MyoRobotics/MyoRobotics-Documentation/source/assembly/overview-joints-ass.rst

Joints
######

.. toctree::
   :maxdepth: 1
   :glob:

   joint-ass-j22.rst
