MyoRobotics/MyoRobotics-Documentation/source/designPrimitives/designPrimitivesLibrary.rst

Content of the design primitive library
=======================================

Organization and description of the library elements
----------------------------------------------------

To simplify the presentation of the library elements and provide a
framework for future extensions, the developed hardware elements are
organized, for each DP functional category, using the following
hierarchical classification:

Types        (T)    are used to distinguish the hardware elements on the basis of their design principle.

Varieties    (V)    are used, if needed, to distinguish the hardware elements based on the same design principles, on the basis of the technical implementation.

The description of each variety follows the following structure:

+----------------------------------+--------------------------------------------------------------------------------------------------------------------------------+
| Illustrations                    | regroup figure and graphics illustrating the library element and its main features                                             |
+==================================+================================================================================================================================+
| Dimensions                       | list the element’s most important dimensions                                                                                   |
+----------------------------------+--------------------------------------------------------------------------------------------------------------------------------+
| Features                         | provide a textual explanation of the element’s main features                                                                   |
+----------------------------------+--------------------------------------------------------------------------------------------------------------------------------+
| Material and fabrication         | detail the materials and fabrication methods foreseen for the various parts of the library element                             |
+----------------------------------+--------------------------------------------------------------------------------------------------------------------------------+
| Integration of the electronics   | if needed, provides more details about the embedded electronic component and their integration in the hardware element         |
+----------------------------------+--------------------------------------------------------------------------------------------------------------------------------+
| Accessories                      | lists the additional pieces of hardware usable with the library element, if any                                                |
+----------------------------------+--------------------------------------------------------------------------------------------------------------------------------+
| Implemented instances            | list the instances of the hardware elements that have been implemented so far, with their corresponding names and dimensions   |
+----------------------------------+--------------------------------------------------------------------------------------------------------------------------------+

Overview of the implemented library elements
--------------------------------------------

Mechanical couplings
~~~~~~~~~~~~~~~~~~~~

Structural Bond
++++++++++++++++++++++++++++++++++++++++++++++
.. _D3.4_image1:
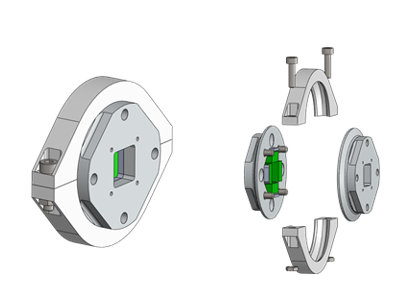
[picture p31: source/designPrimitives/images/image1.png]


   Type 1: Flange clamp with conical flange

Anchor Fastener
++++++++++++++++++++++++++++++++++++++++++++++

.. _D3.4_image3:
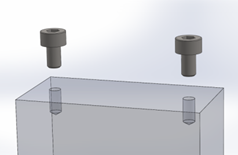
[picture p32: source/designPrimitives/images/image3.png]


    Type 1: Screw Fasteners

Cable attachment
++++++++++++++++++++++++++++++++++++++++++++++

.. _D3.4_image4:
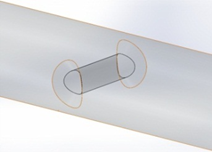
[picture p33: source/designPrimitives/images/image4.png]


    Type 1: Through hole

.. _D3.4_image5:
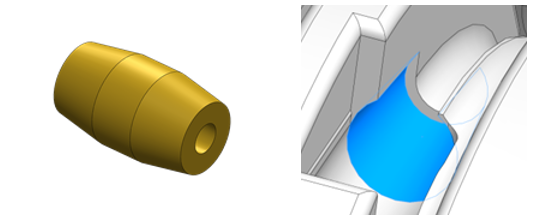
[picture p34: source/designPrimitives/images/image5.png]


    Type 2: Conical socket

Design Primitives
~~~~~~~~~~~~~~~~~

MYO-Bones
++++++++++++++++++++++++++++++++++++++++++++++

.. _D3.4_image7:
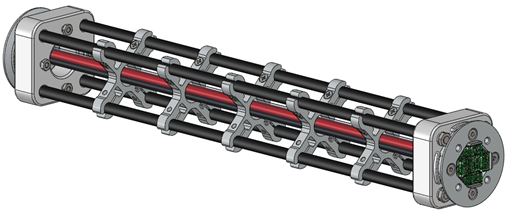
[picture p35: source/designPrimitives/images/image7.png]


    Type 1: Parallel Assemblies - Four Round Tubes Fibres

.. _D3.4_image8:
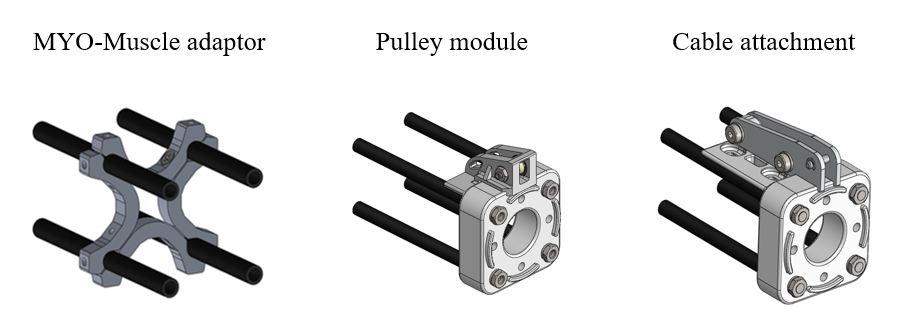
[picture p36: source/designPrimitives/images/image8.png]


    Accessories

.. _D3.4_image11:
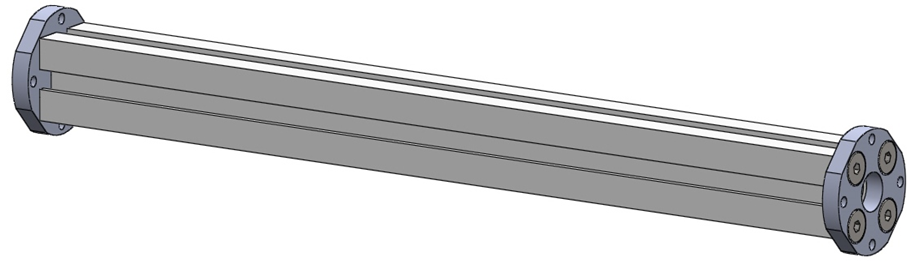
[picture p37: source/designPrimitives/images/image11.png]


    Type 2: Monolithic core - T-slot profile

.. _D3.4_image12:
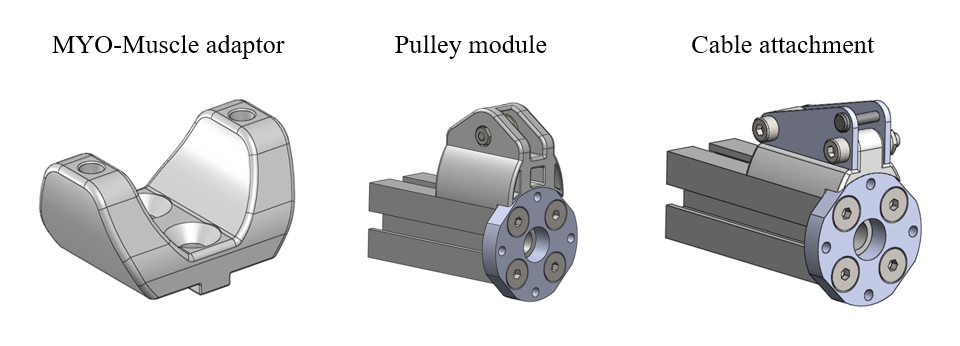
[picture p38: source/designPrimitives/images/image12.png]


    Accessories

MYO-Joints
++++++++++++++++++++++++++++++++++++++++++++++

.. _D3.4_image15:
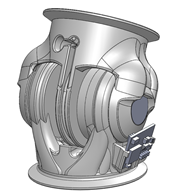
[picture p39: source/designPrimitives/images/image15.png]


    Type 1: Symmetric Hinge

.. _D3.4_image16:
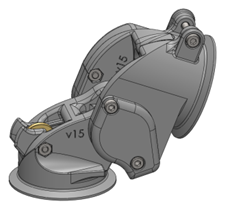
[picture p40: source/designPrimitives/images/image16.png]


    Type 2: Asymmetric Hinge

.. _D3.4_image17:
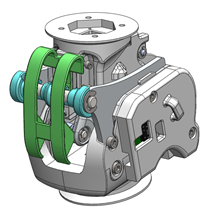
[picture p41: source/designPrimitives/images/image17.png]


    Type 2: Revised Asymmetric Hinge

.. _D3.4_image18:
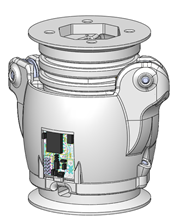
[picture p42: source/designPrimitives/images/image18.png]


    Type 3: Pivot

.. _D3.4_image19:
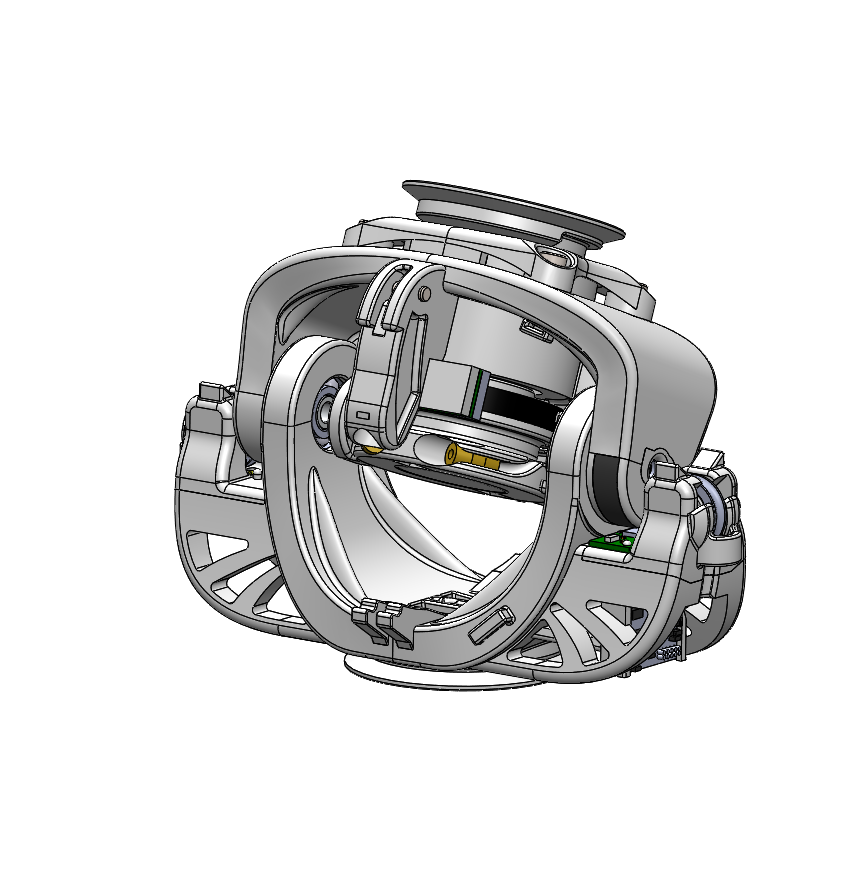
[picture p43: source/designPrimitives/images/image19.png]


    Type 4: Hinge-Pivot

.. _D3.4_image20:
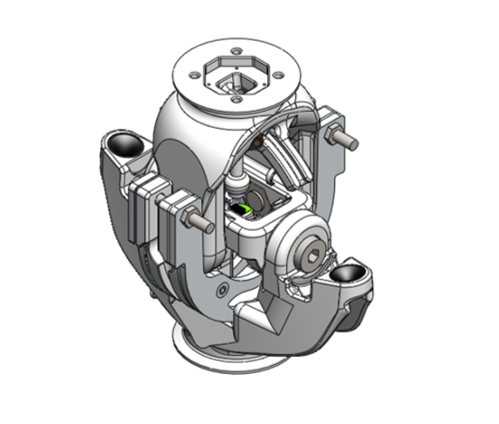
[picture p44: source/designPrimitives/images/image20.png]


    Type 5: Hinge-Hinge

MYO-Muscles
++++++++++++++++++++++++++++++++++++++++++++++

.. _D3.4_image21:
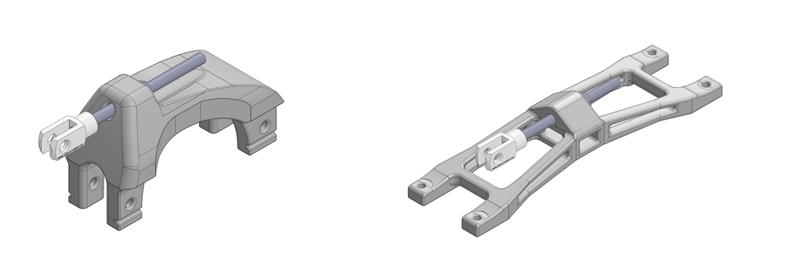
[picture p45: source/designPrimitives/images/image21.png]


    Type 0: Passive Muscle - Simple spring

.. _D3.4_image23:
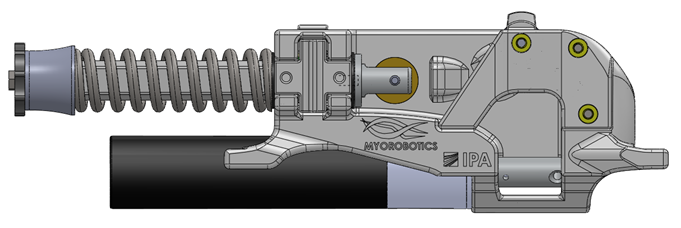
[picture p46: source/designPrimitives/images/image23.png]


    Type 1: Unilateral Series Elastic Actuator - Compression spring

MYO-Ganglion
++++++++++++++++++++++++++++++++++++++++++++++

.. _D3.4_image24:
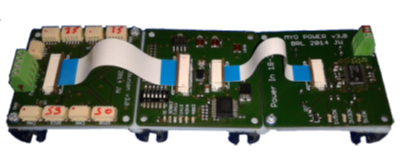
[picture p47: source/designPrimitives/images/image24.png]


    Type 1: ECU with FlexRay bus
