MyoRobotics/MyoRobotics-Documentation/source/partners/GI.rst

General Interfaces
===================
`General Interfaces
<https://www.gi.ai/#>`_ can provide fully assembled solutions based on MyoRobotics components.
