MyoRobotics/MyoRobotics-Documentation/source/controllers/images/CanConnectionMyoGanglionToDistributionBoard.pdf

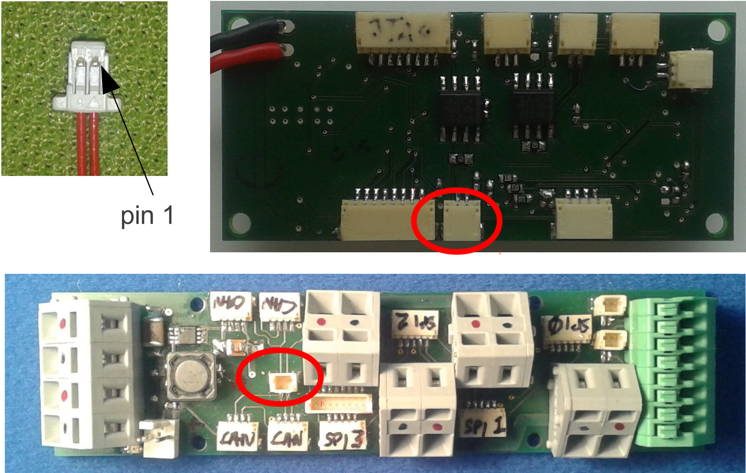
[picture p142: page 1]

pin 1
