MyoRobotics/MyoRobotics-Documentation/source/controllers/images/FlexRayConnectionMyoGanglionToDistributionBoard.pdf

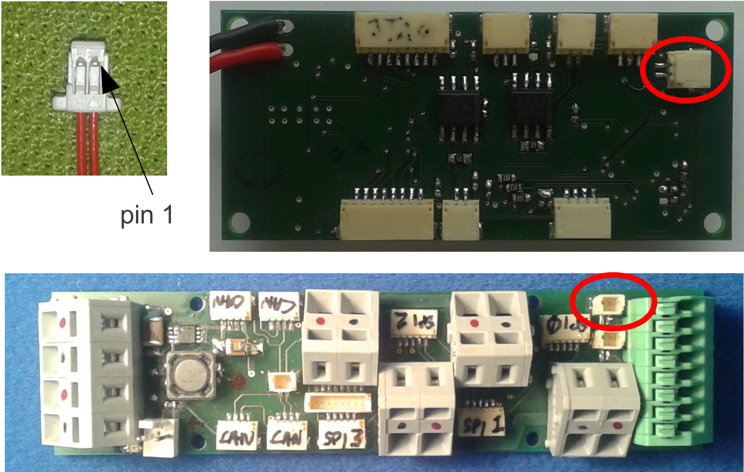
[picture p143: page 1]

pin 1
