MyoRobotics/MyoRobotics-Documentation/source/controllers/images/ganglionBoardWithLabelsHeatsink.pdf

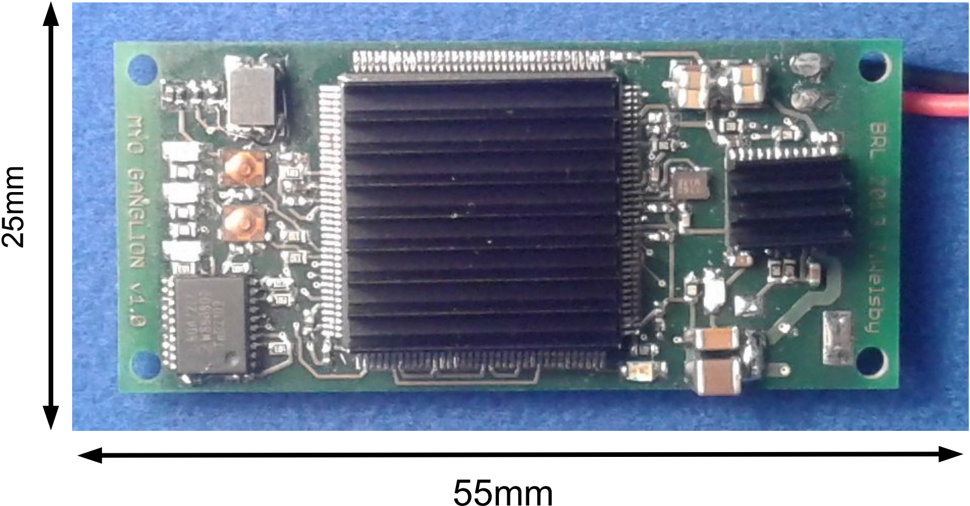
[picture p144: page 1]

55mm

2

5

m

m
