MyoRobotics/MyoRobotics-Documentation/source/controllers/images/jointAngleSensorWithConnector.pdf

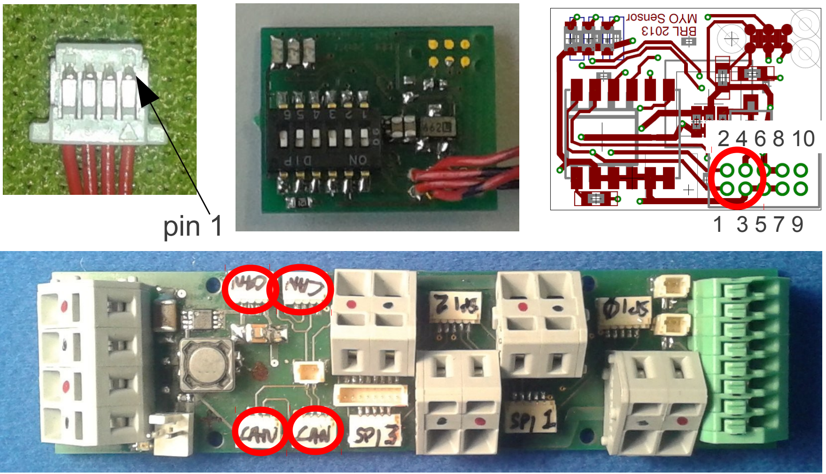
[picture p145: page 1]

pin 1 | 1 3 5 7 9 2 4 6 8 10
