MyoRobotics/MyoRobotics-Documentation/source/controllers/images/jointAngleSensorWithMagneticSensor.pdf

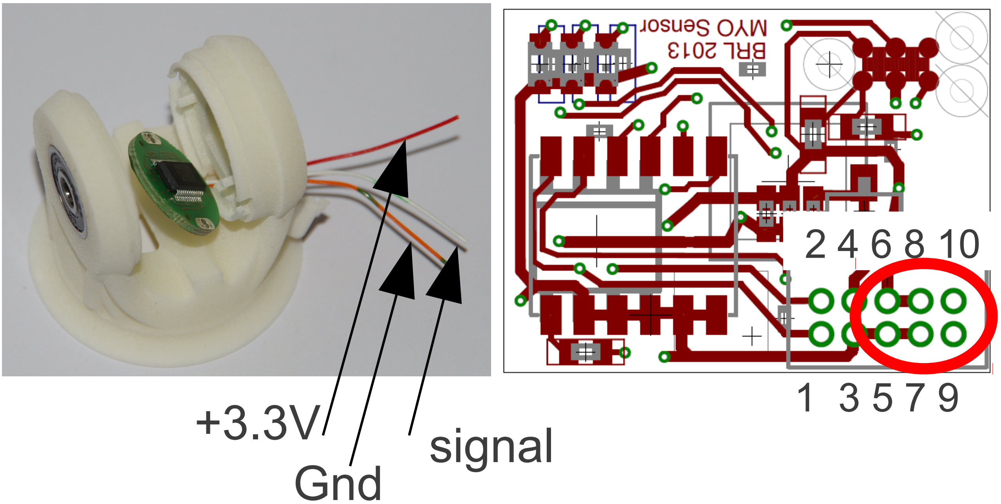
[picture p146: page 1]

1 3 5 7 9

2 4 6 8 10

### Gnd

### +3.3V signal
