MyoRobotics/MyoRobotics-Documentation/source/controllers/images/MotorToSpringSensorConnectivity.pdf

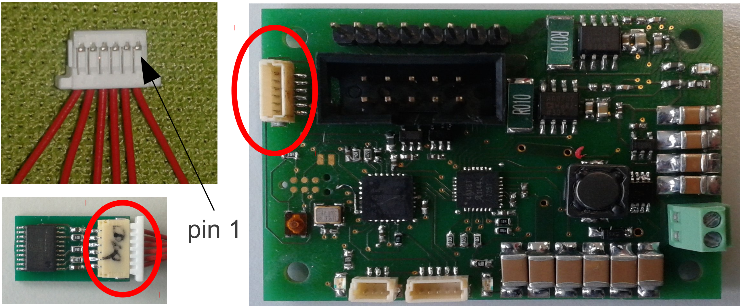
[picture p147: page 1]

pin 1
