MyoRobotics/MyoRobotics-Documentation/source/controllers/images/powerDistributionBoardWithLabels.pdf

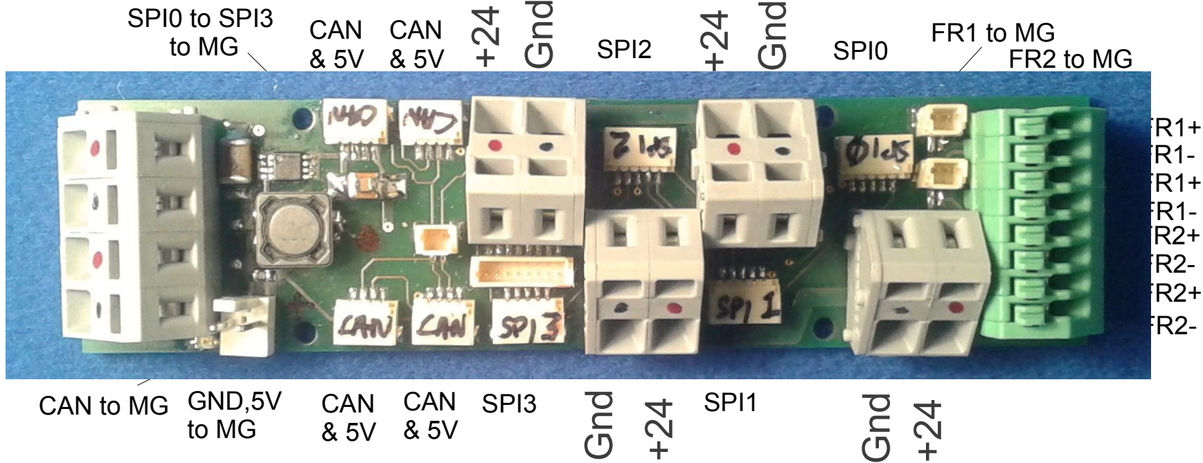
[picture p148: figure]
CAN & 5V; SPI2; SPI3; SPI0; SPI1; GND,5V to MG; CAN to MG; SPI0 to SPI3; CAN

+24

+24

## Gnd

## Gnd
