MyoRobotics/MyoRobotics-Documentation/source/controllers/images/SpiConnectionMotorDriverToDistributionBoard.pdf

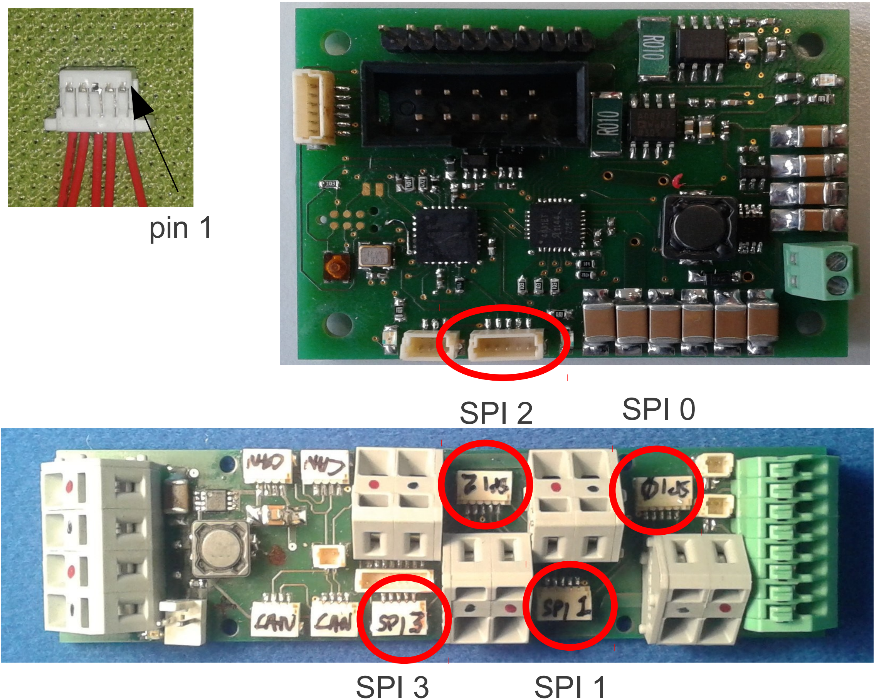
[picture p149: page 1]

pin 1

SPI 0

SPI 1

SPI 2

SPI 3
