MyoRobotics/MyoRobotics-Documentation/source/controllers/images/SpiConnectionMyoGanglionToDistributionBoard.pdf

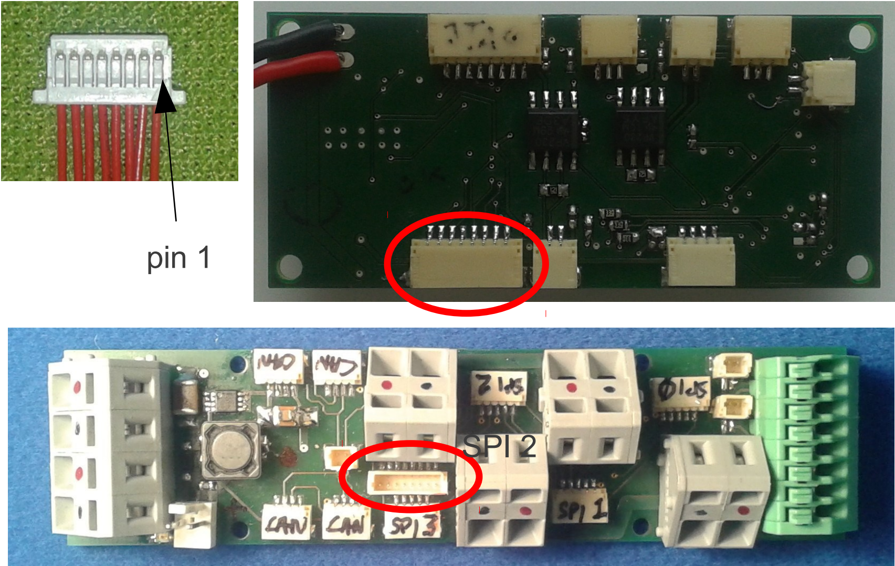
[picture p150: page 1]

pin 1

SPI 2
