MyoRobotics/MyoRobotics-Documentation/source/controllers/images/jointAngleSensorWithLabels.pdf

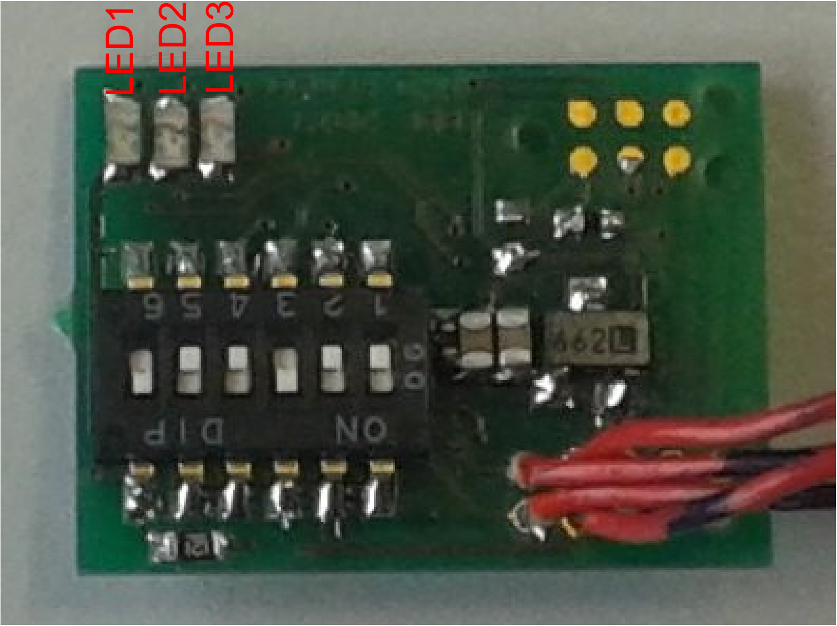
[picture p151: page 1]

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
