MyoRobotics/MyoRobotics-Documentation/source/controllers/images/topViewJointSensorBoardWithLEDLabels-crop.pdf

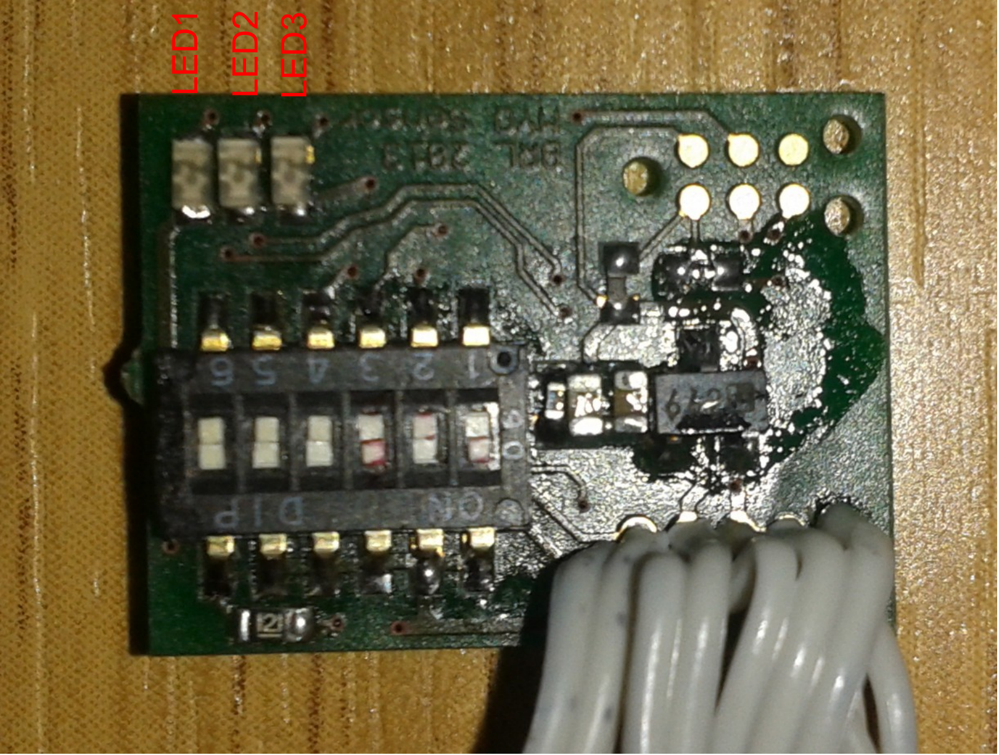
[picture p152: page 1]

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
