MyoRobotics/MyoRobotics-Documentation/source/controllers/images/displacementSensorBoard.jpg

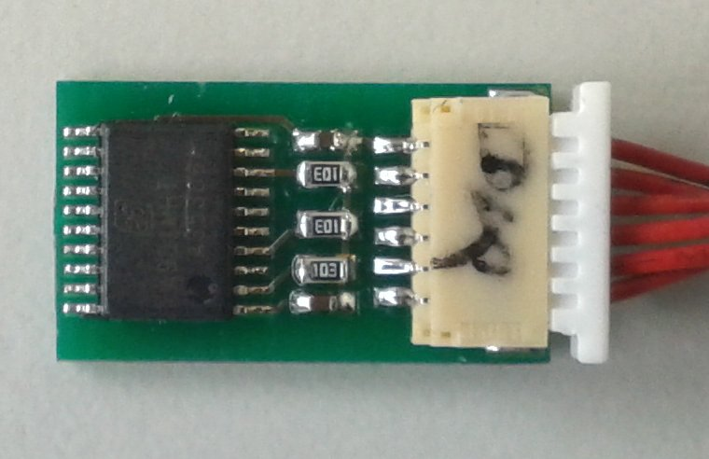
source/controllers/images/displacementSensorBoard.jpg
