MyoRobotics/MyoRobotics-Documentation/source/controllers/images/eightPinConnector.jpg

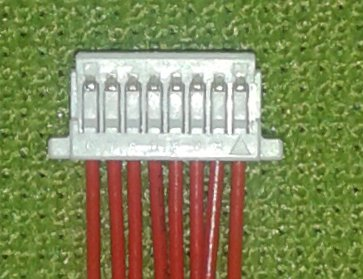
source/controllers/images/eightPinConnector.jpg
