MyoRobotics/MyoRobotics-Documentation/source/controllers/images/jointAngleSensorCloseUp.jpg

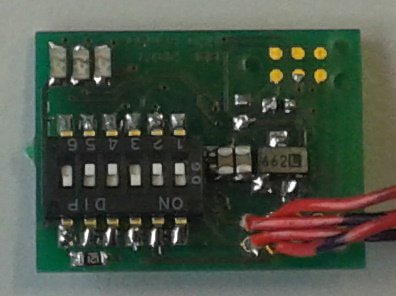
source/controllers/images/jointAngleSensorCloseUp.jpg
