MyoRobotics/MyoRobotics-Documentation/source/controllers/images/jointSensorBoardCloseUp.jpg

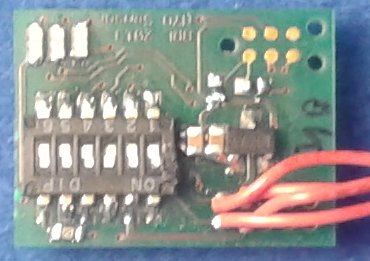
source/controllers/images/jointSensorBoardCloseUp.jpg
