MyoRobotics/MyoRobotics-Documentation/source/controllers/images/magneticSensorForJoint.jpg

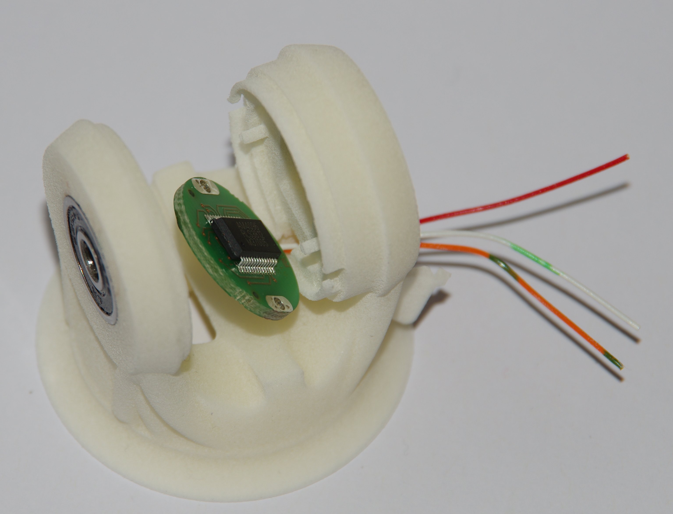
source/controllers/images/magneticSensorForJoint.jpg
