MyoRobotics/MyoRobotics-Documentation/source/controllers/images/magneticSensorPrinciple.jpg

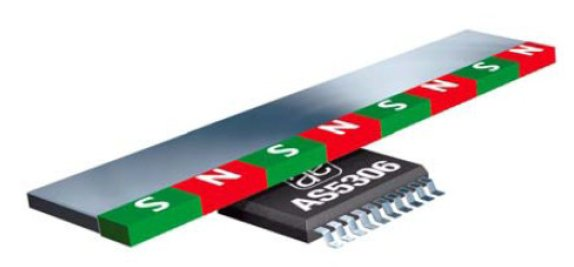
source/controllers/images/magneticSensorPrinciple.jpg
