MyoRobotics/MyoRobotics-Documentation/source/controllers/images/motorDriverBoard.jpg

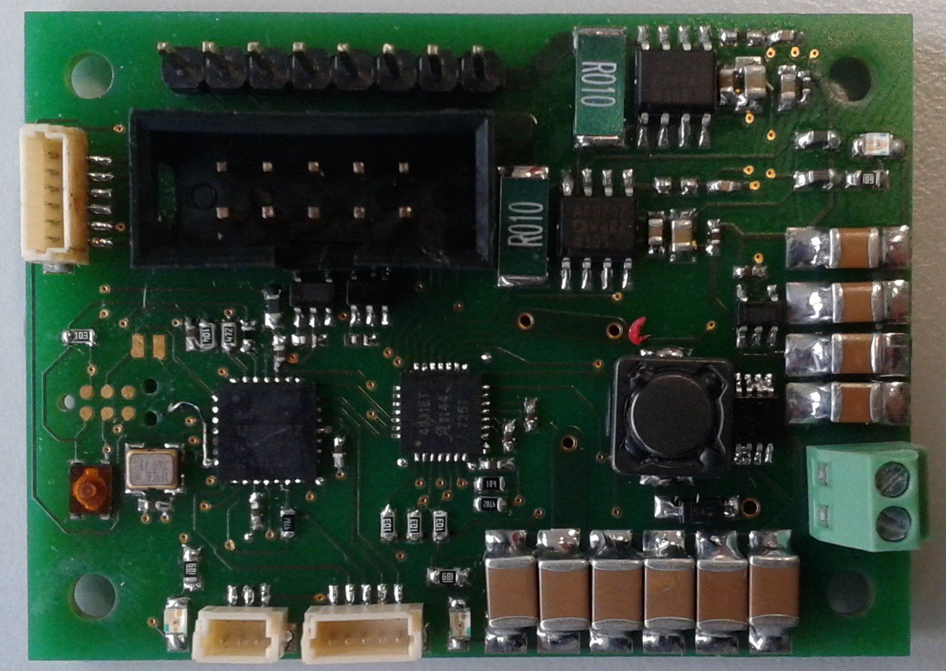
source/controllers/images/motorDriverBoard.jpg
