MyoRobotics/MyoRobotics-Documentation/source/controllers/images/motorDriverBoardScenicView.jpg

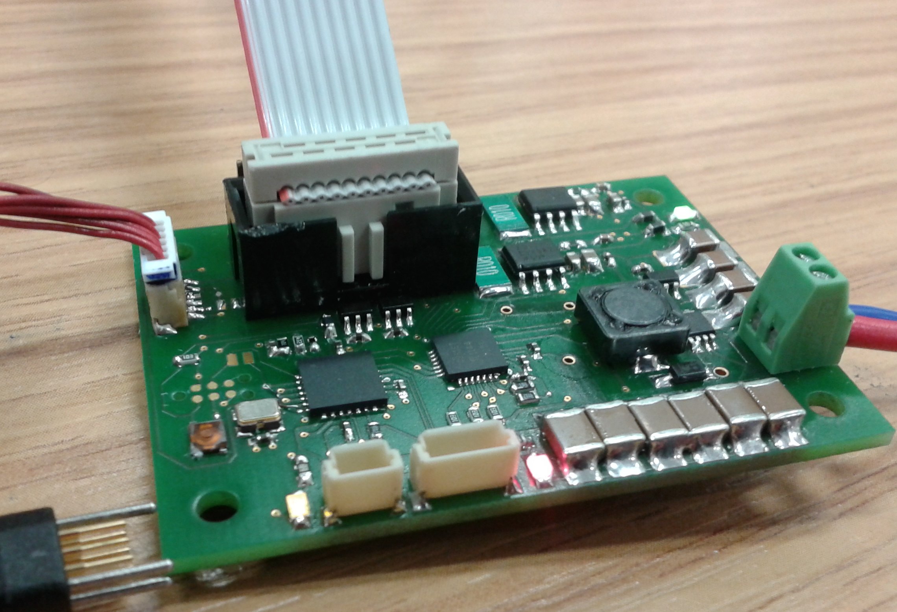
source/controllers/images/motorDriverBoardScenicView.jpg
