MyoRobotics/MyoRobotics-Documentation/source/controllers/images/MyoGanglionConnectorSide.jpg

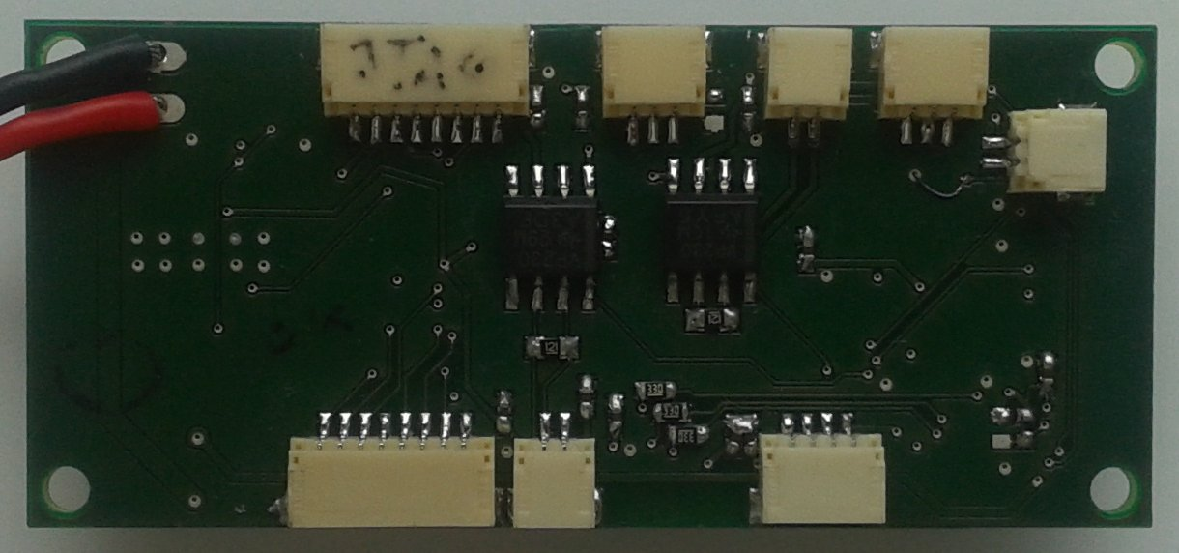
source/controllers/images/MyoGanglionConnectorSide.jpg
