MyoRobotics/MyoRobotics-Documentation/source/controllers/images/twoPinConnector.jpg

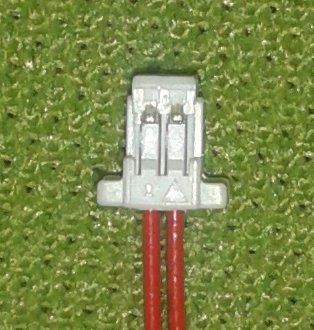
source/controllers/images/twoPinConnector.jpg
