MyoRobotics/MyoRobotics-Documentation/source/designPrimitives/images/GanglionMount.png

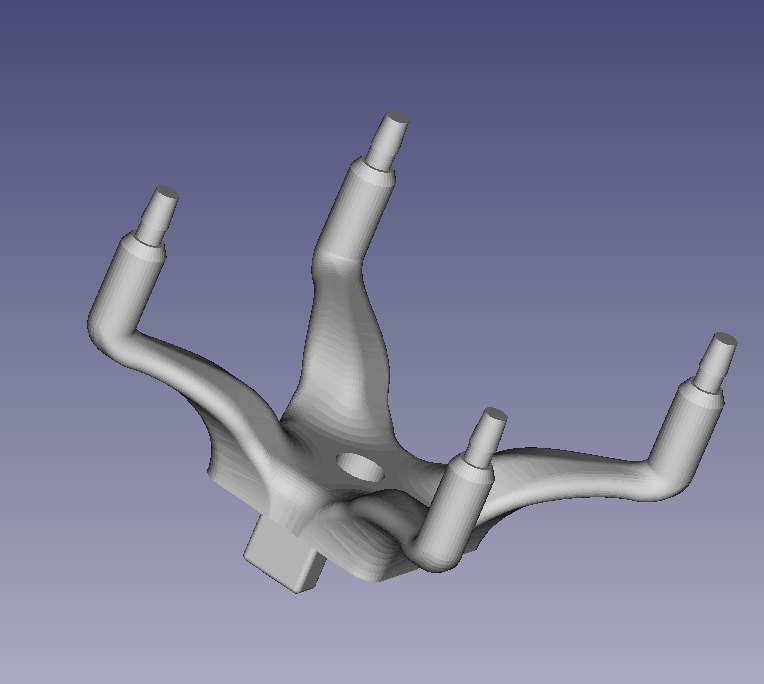
source/designPrimitives/images/GanglionMount.png
