MyoRobotics/MyoRobotics-Documentation/source/designPrimitives/images/GanglionStack.png

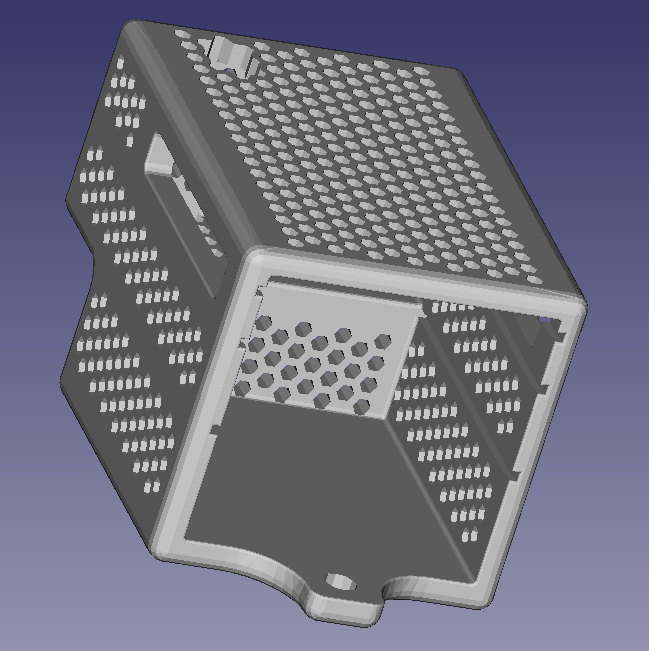
source/designPrimitives/images/GanglionStack.png
