MyoRobotics/MyoRobotics-Documentation/source/designPrimitives/images/image92.jpg

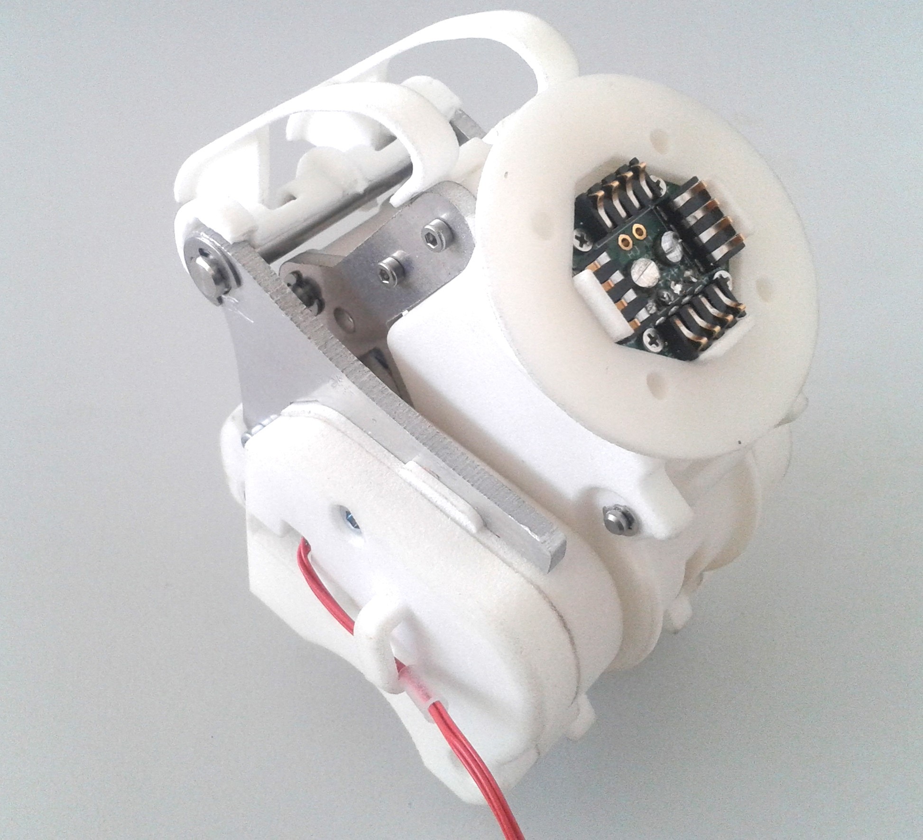
source/designPrimitives/images/image92.jpg
