MyoRobotics/MyoRobotics-Documentation/source/designPrimitives/images/image200.png

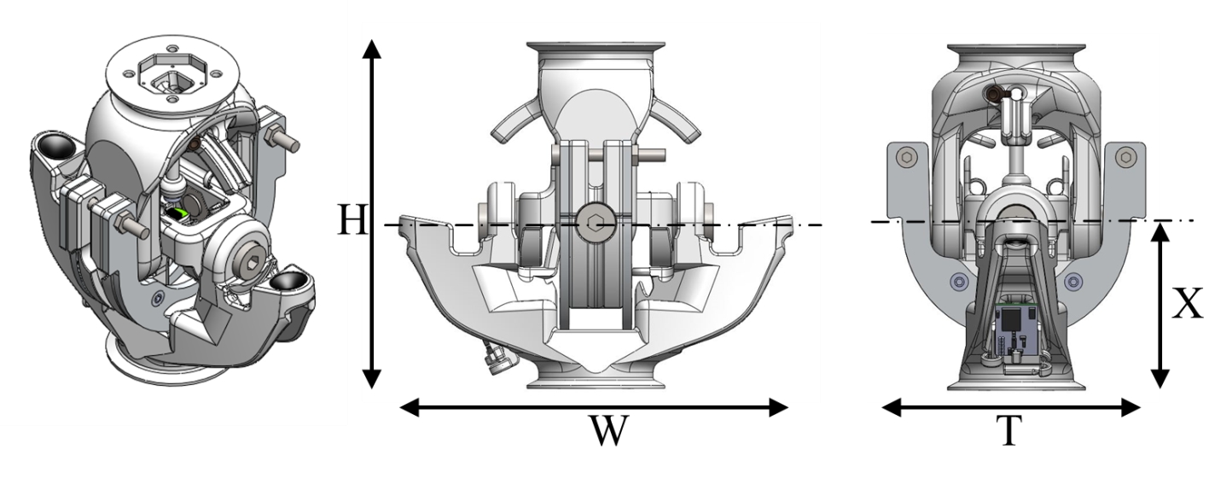
source/designPrimitives/images/image200.png
