MyoRobotics/MyoRobotics-Documentation/source/assembly/appl-myoarm.rst

MyoArm
#######

The MyoArm is a 13 myo muscle system. 9 muscles actuate the shoulder complex, 2 muscles the upper arm and 2 muscles the lower arm (1DOF hand, forearm rotation).

Partslist
----------
The parts list is maintained at `roboy.open-aligni.com <https://roboy.open-aligni.com/part/show/372#tab_part-list>`_.

External users can access it using the following credentials:

- user: roboy
- password: roboy

.. csv-table:: Partslist of MyoArm
  :header: "Level","Manufacturer P/N","Manufacturer Name","Part Type","Description","Quantity","Designator"
  :file: MyoArmV1.2.csv
