MyoRobotics/MyoRobotics-Documentation/source/controllers/images/test1Expr1.pdf

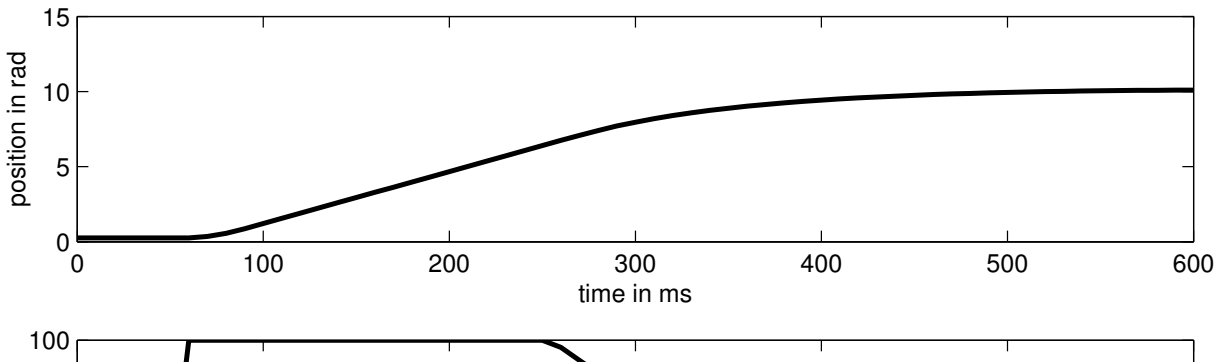
[picture p223: figure]
time in ms; position in rad

−500

50
DC in %

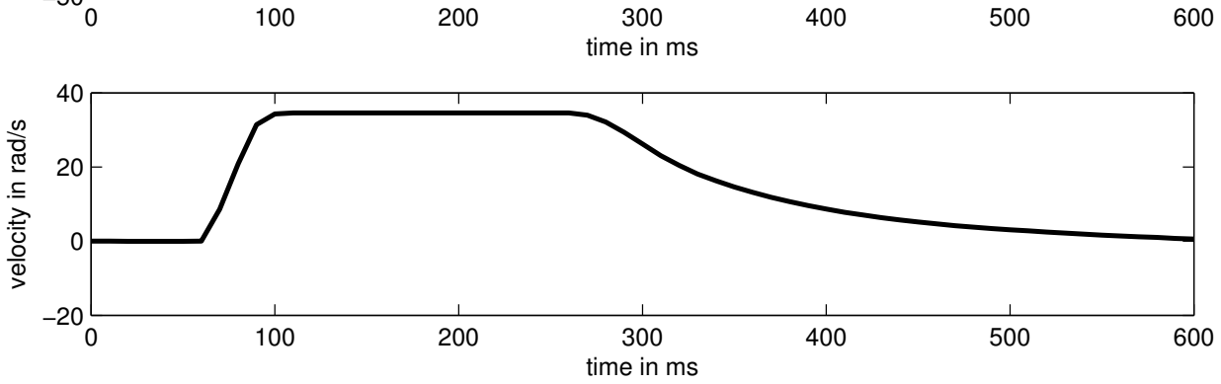
[picture p224: figure]
time in ms; velocity in rad/s
