MyoRobotics/MyoRobotics-Documentation/source/controllers/images/test2Expr1.pdf

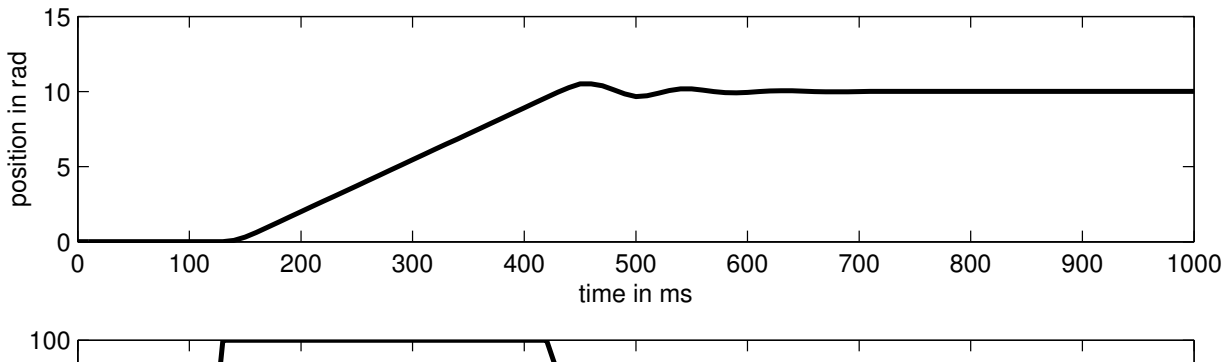
[picture p225: figure]
time in ms; position in rad

0 | 100 | 200 | 300 | 400 | 500 | 600 | 700 | 800 | 900 | 1000

−100

−500

50

time in ms

DC in %

0 | 100 | 200 | 300 | 400 | 500 | 600 | 700 | 800 | 900 | 1000

−40

−200

20

40

time in ms

velocity in rad/s
