MyoRobotics/MyoRobotics-Documentation/source/controllers/images/test2Expr2.pdf

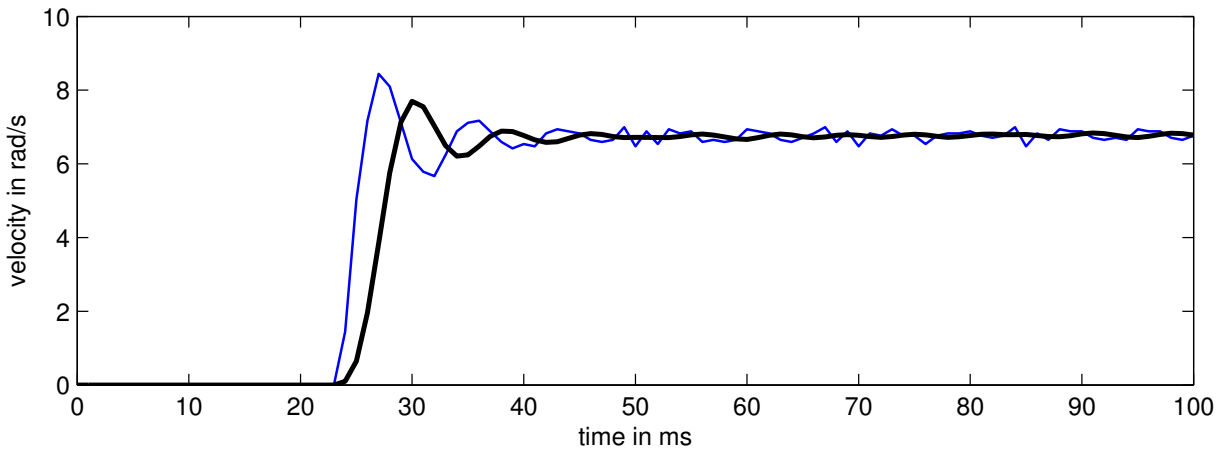
[picture p226: figure]
time in ms; velocity in rad/s
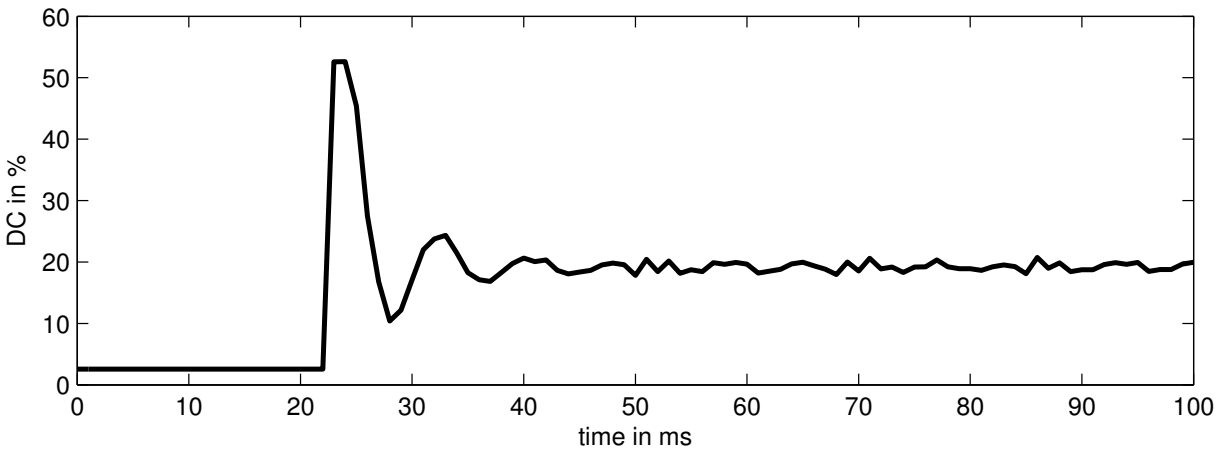
[picture p227: figure]
time in ms
