MyoRobotics/MyoRobotics-Documentation/source/controllers/images/systemOverviewECUAndCommsIntegrationSeptembe2013.pdf

M

M

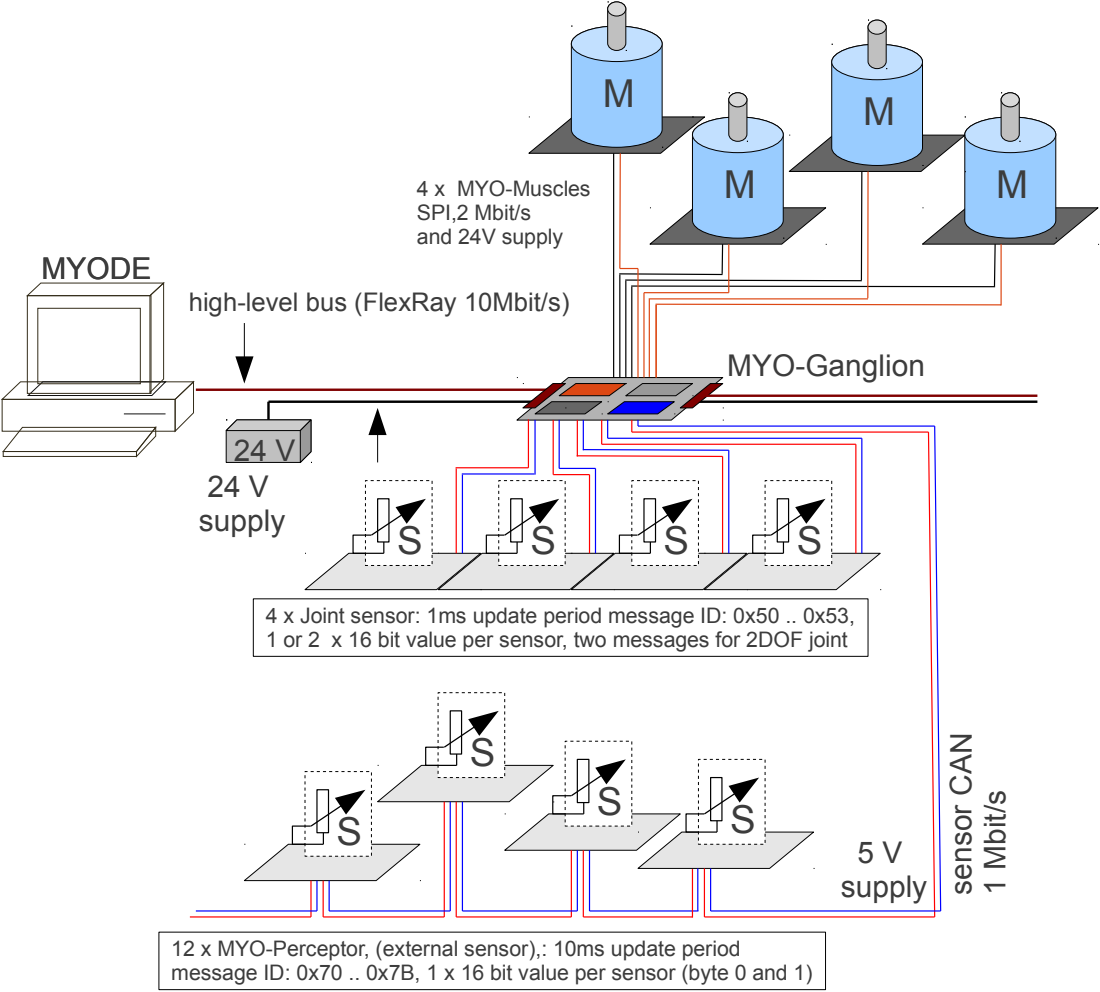
[picture p228: page 1]
MYO-Ganglion; MYODE; 24 V 24 V supply; 5 V supply s; bit/s; 4 x MYO-Muscles SPI,2 Mbit/s and 24V supply

high-level bus (FlexRay 10Mbit/s)

4 x Joint sensor: 1ms update period message ID: 0x50 .. 0x53,
1 or 2 x 16 bit value per sensor, two messages for 2DOF joint

12 x MYO-Perceptor, (external sensor),: 10ms update period
message ID: 0x70 .. 0x7B, 1 x 16 bit value per sensor (byte 0 and 1)
