MyoRobotics/MyoRobotics-Documentation/source/controllers/images/test1Expr2.pdf

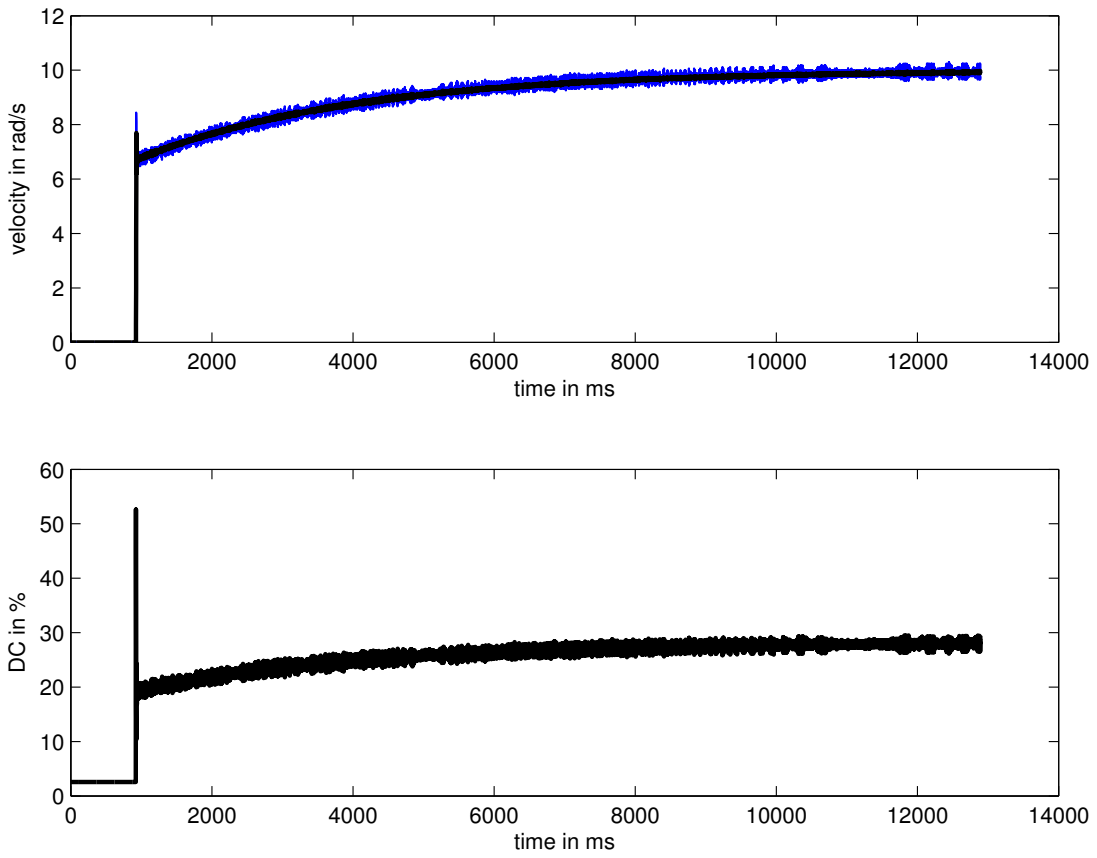
[picture p229: page 1]

velocity in rad/s

time in ms
