MyoRobotics/MyoRobotics-Documentation/source/controllers/images/test26000Myo1DOFPlot0.pdf

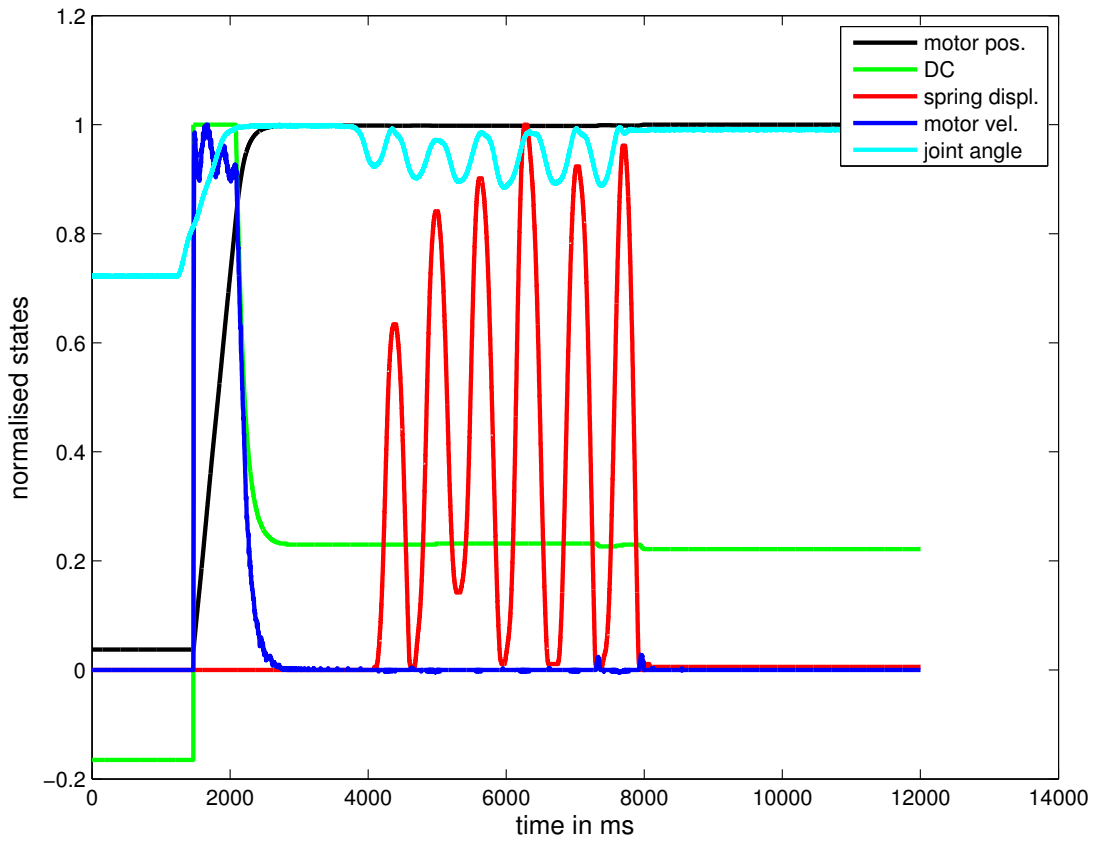
[picture p230: page 1]
normalised states; motor pos. DC spring displ. motor vel. joint angle

time in ms
