MyoRobotics/MyoRobotics-Documentation/source/controllers/images/test26000Myo1DOFPlot1.pdf

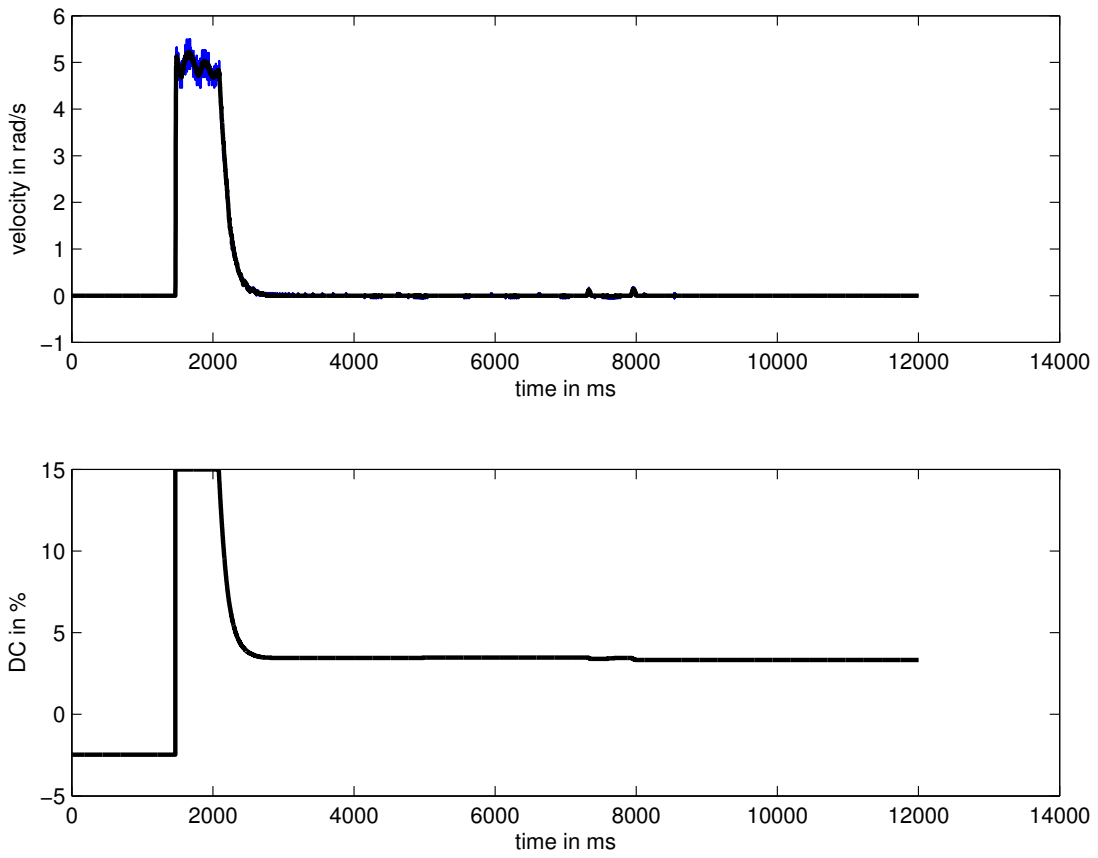
[picture p231: page 1]

velocity in rad/s

time in ms
