MyoRobotics/MyoRobotics-Documentation/source/controllers/images/test26000Myo1DOFPlot2.pdf

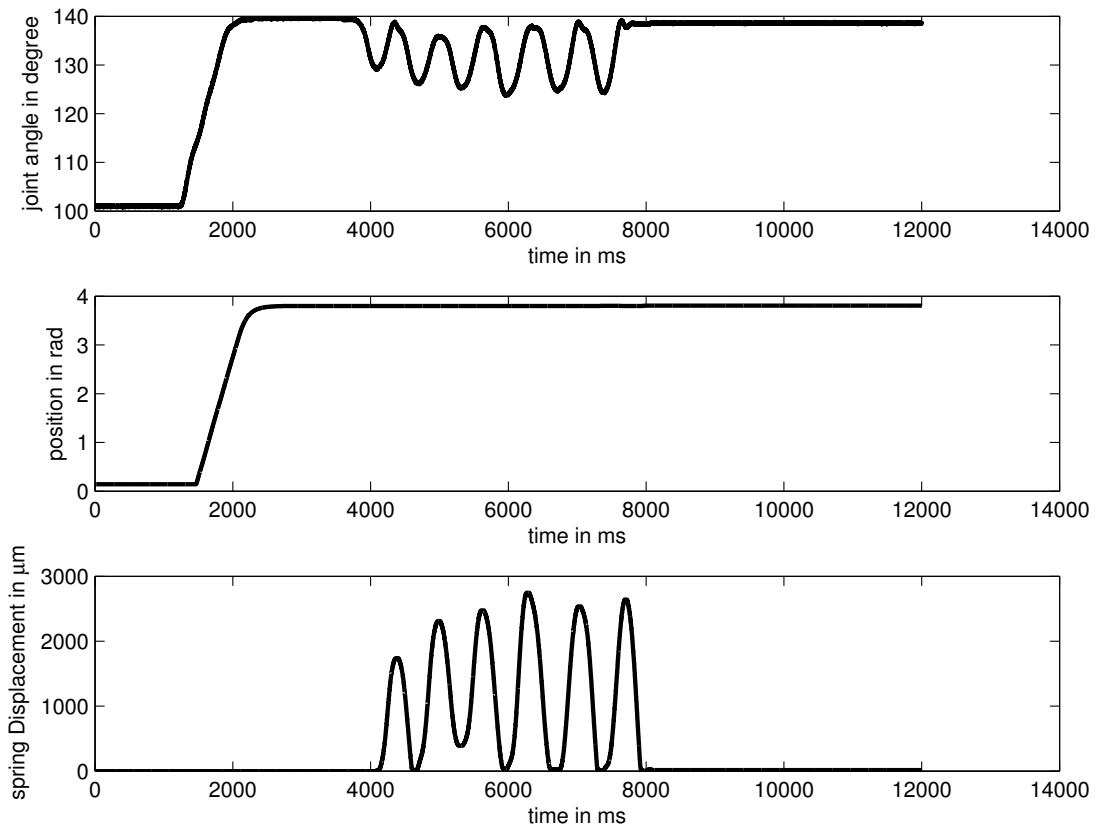
[picture p232: page 1]

joint angle in degree

time in ms

position in rad

spring Displacement in µm
