MyoRobotics/MyoRobotics-Documentation/source/controllers/images/motorDriverVersion2.pdf

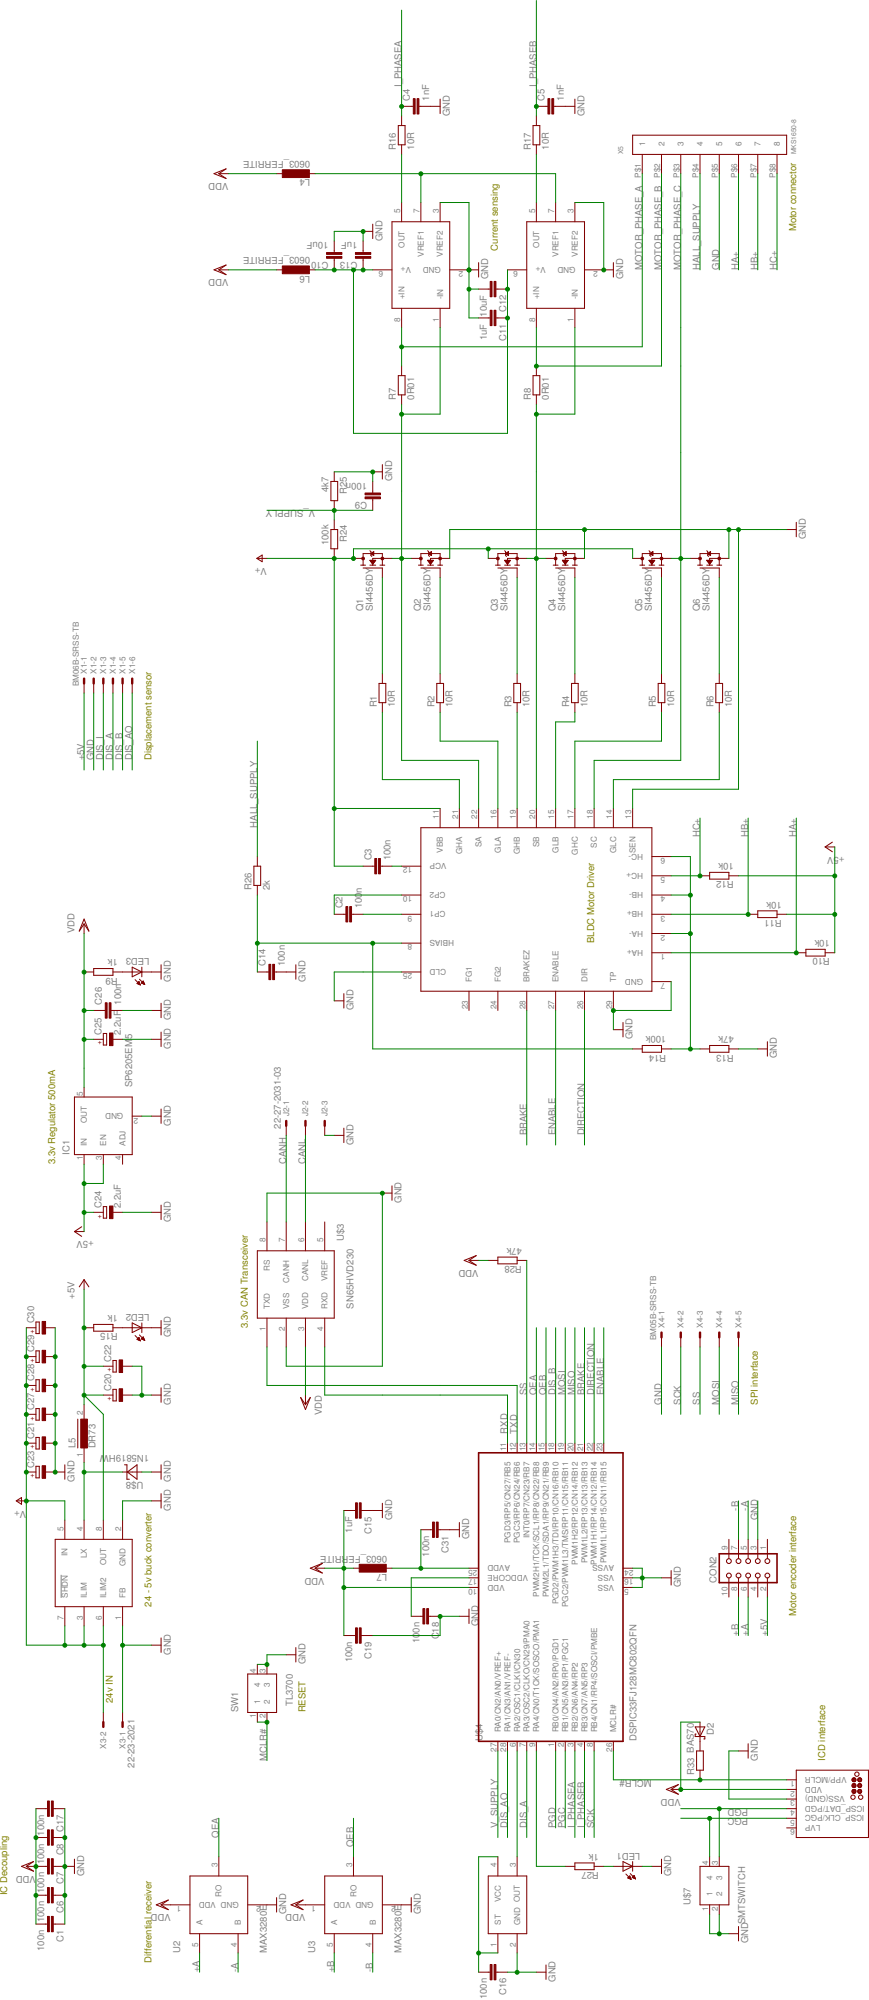
[picture p233: page 1]

2.2uF 2.2uF 100n GND GND GND GND WH9185 N1 GND

ICD interface Motor encoder interface SPI interface

24 - 5v buck converter Differential receiver
