MyoRobotics/MyoRobotics-Documentation/source/controllers/images/sensorBoardLayout.pdf

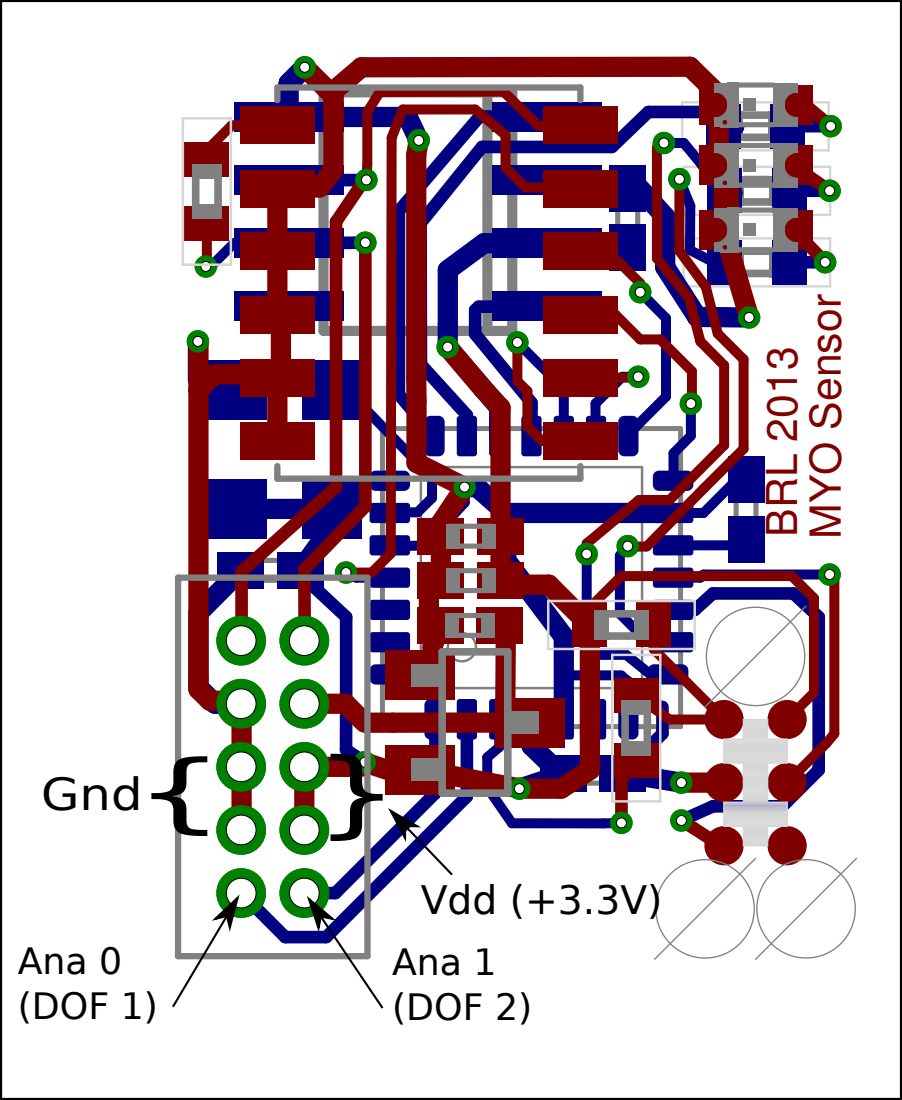
[picture p234: page 1]
BRL 2013; MYO Sensor; Gnd{; Vdd (+3.3V); Ana 0 (DOF 1); Ana 1 (DOF 2)
