MyoRobotics/MyoRobotics-Documentation/source/controllers/images/CircuitDiagrams/jointSensorCircuitVersion4.pdf

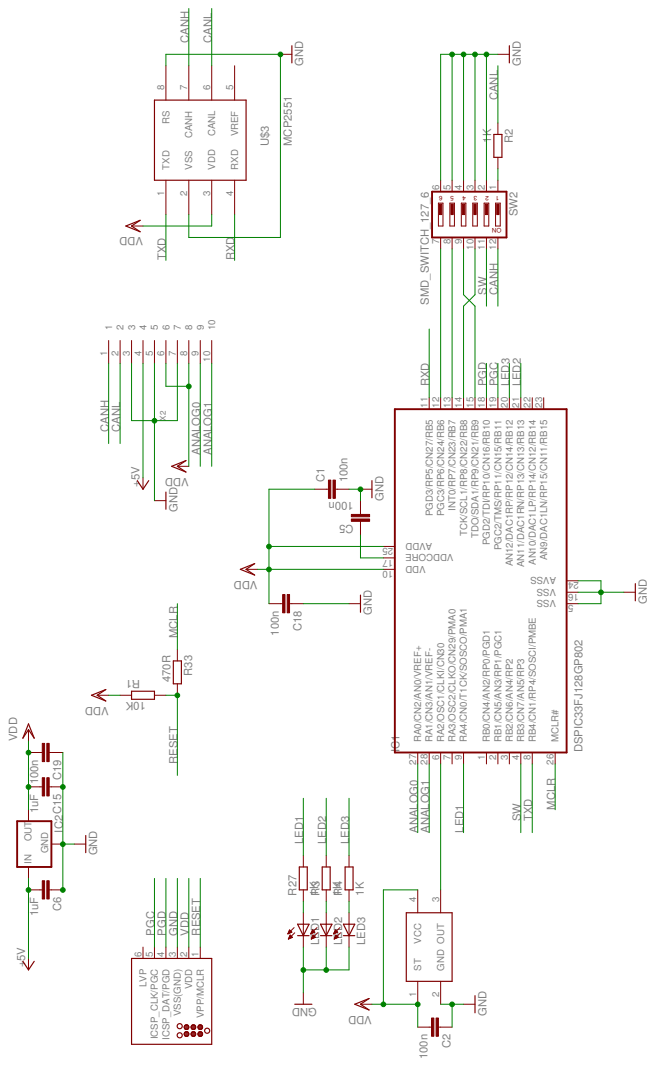
[picture p235: page 1]

MCP2551 1uF GND GND 470R GND 100nGND 100n 1K DNG 100n GND K01 1K1K 100n GND +5V GND DSPIC33FJ128GP802 DDV DDV DDV n001 1uF +5V VDD GND DDV SMD_SWITCH_127_6 1K DDV U$3 TXD 1 VSS 2 VDD 3 RXD 4 VREF 5 CANL 6 CANH 7 RS 8 C15 R33 C18 C19 LED1 R27 C1 1 R R3 R4 LED2 LED3 C2 X2 1 1 2 2 3 3 4 4 5 5 6 6 7 7 8 8 9 9 10 10 IC1RA0/CN2/AN0/VREF+ 27 RA1/CN3/AN1/VREF- 28 RA2/OSC1/CLKI/CN30 6 RA3/OSC2/CLKO/CN29/PMA0 7 RA4/CN0/T1CK/SOSCO/PMA1 9 RB0/CN4/AN2/RP0/PGD1 1 RB1/CN5/AN3/RP1/PGC1 2 RB2/CN6/AN4/RP2 3 RB3/CN7/AN5/RP3 4 RB4/CN1/RP4/SOSCI/PMBE 8 MCLR# 26 PGD3/RP5/CN27/RB5 11 PGC3/RP6/CN24/RB6 12 INT0/RP7/CN23/RB7 13 TCK/SCL1/RP8/CN22/RB8 14 TDO/SDA1/RP9/CN21/RB9 15 PGD2/TDI/RP10/CN16/RB10 18 PGC2/TMS/RP11/CN15/RB11 19 AN12/DAC1RP/RP12/CN14/RB12 20 AN11/DAC1RN/RP13/CN13/RB13 21 AN10/DAC1LP/RP14/CN12/RB14 22 AN9/DAC1LN/RP15/CN11/RB15 23 DDV 01 EROCDDV 71 DDVA 52 SSV 5 SSV 61 SSVA 42 VPP/MCLR 1 VDD 2 VSS(GND) 3 ICSP_DAT/PGD 4 ICSP_CLK/PGC 5 LVP 6 5 C IC2 GND IN OUT C6 ST 1 GND 2 OUT 3 VCC 4 SW2 789101112 654321 R2 GND CANH CANH CANH CANL CANL CANL MCLR MCLR LED1 LED1 ANALOG0 ANALOG0 ANALOG1 ANALOG1 RXD RXD RESET RESET LED2 LED2 LED3 LED3 VDD PGD PGD PGC PGC TXD TXD SW SW 6 5 4 3 2 1NO
