MyoRobotics/MyoRobotics-Documentation/source/controllers/images/CircuitDiagrams/MYO power distribution pcb.pdf

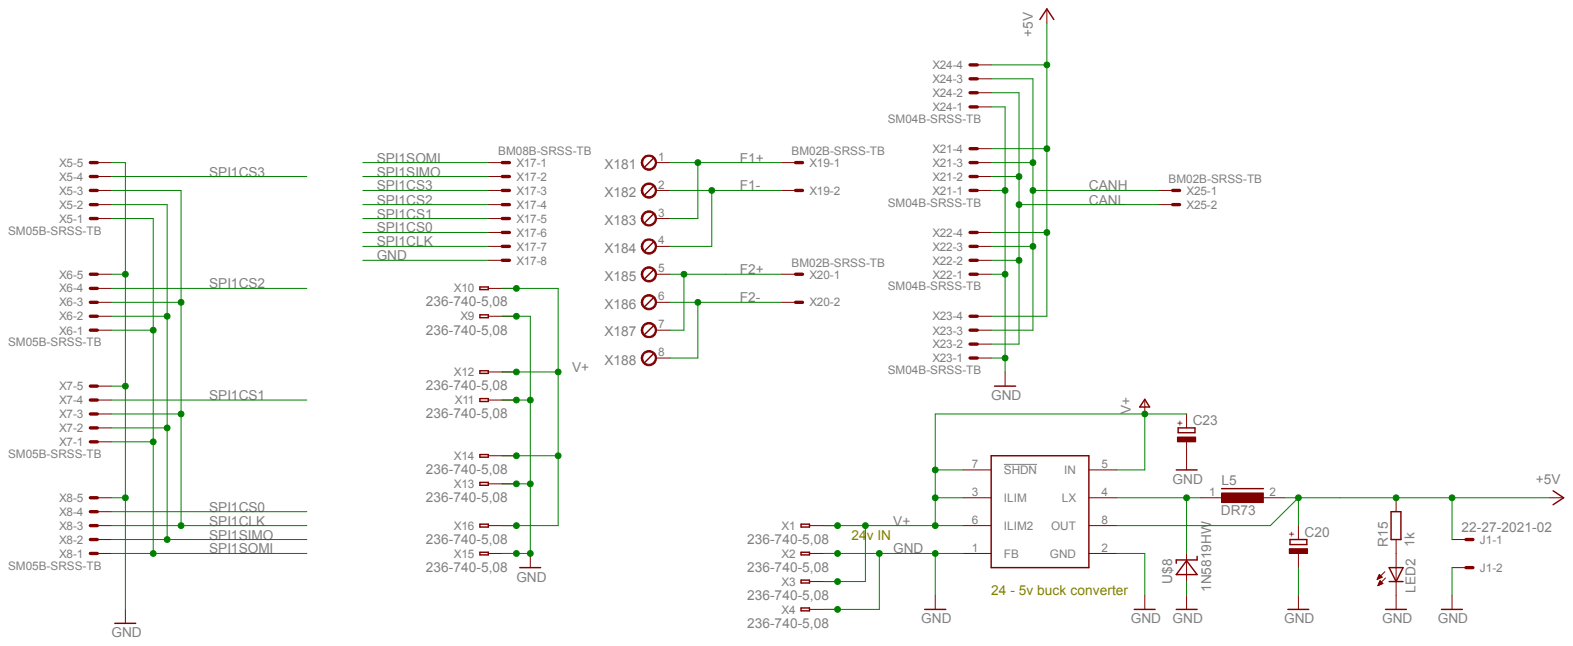
[picture p236: page 1]
24 - 5v buck converter; SM05B-SRSS-TB; BM08B-SRSS-TB; GND; BM02B-SRSS-TB; SM04B-SRSS-TB; SHDN; ILIM; ILIM2; 1 GND; OUT; LED2; SPI1SOMI; SPI1SIMO; SPI1CS2; SPI1CS1; SPI1CS0; SPI1CLK; SPI1CS3; CANL; CANH
