MyoRobotics/MyoRobotics-Documentation/source/controllers/images/jointSensorCircuitVersion4.pdf

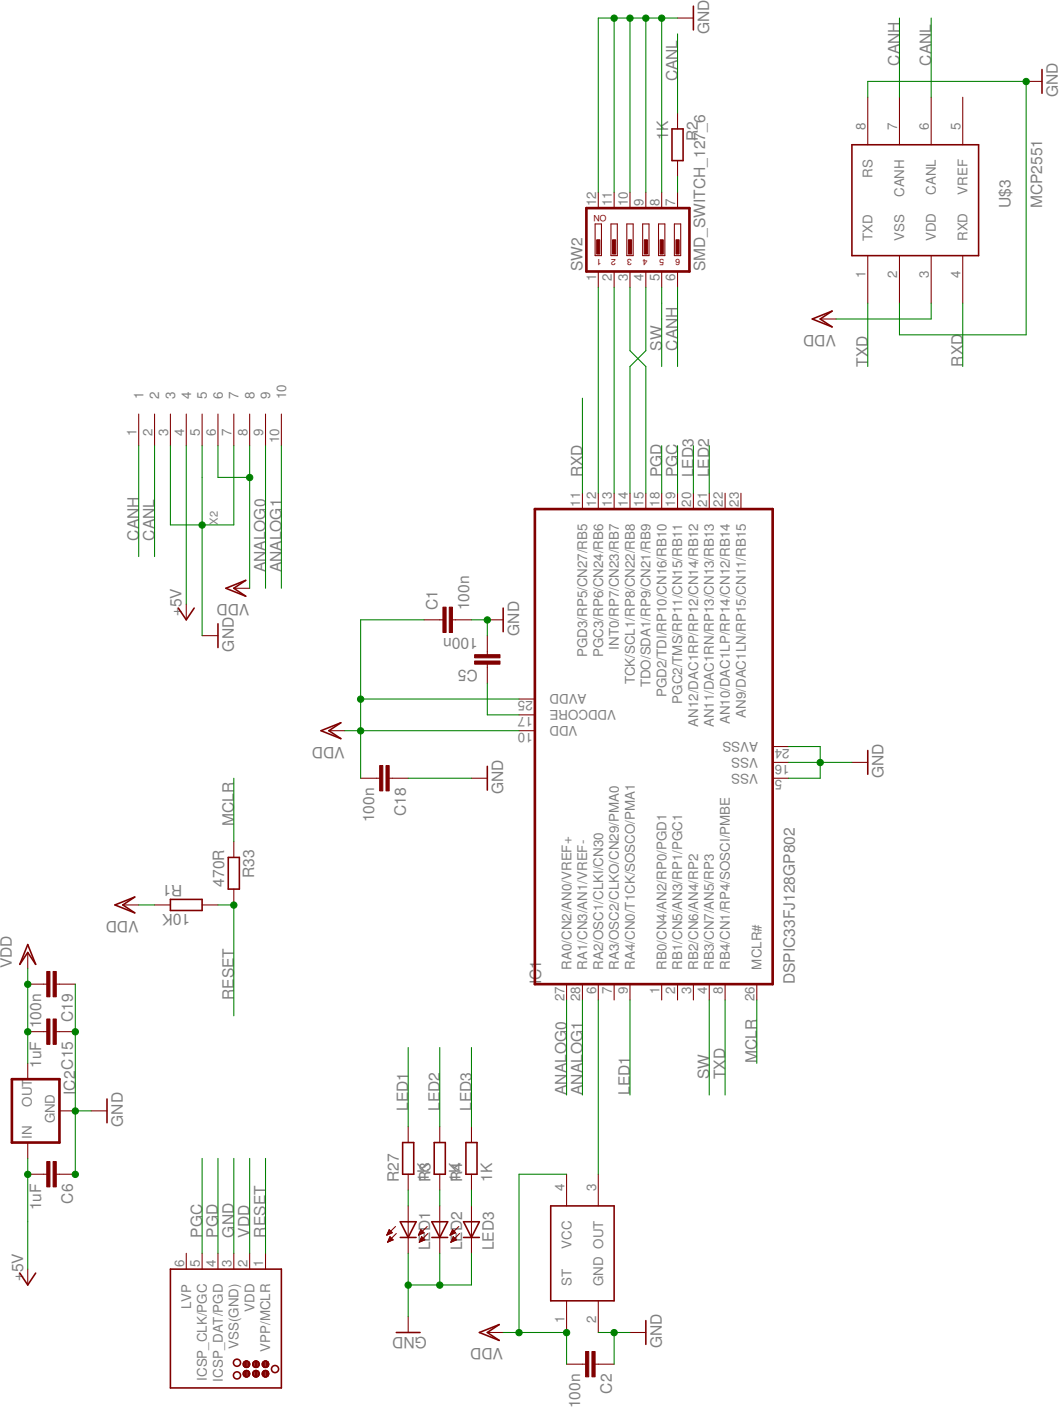
[picture p237: page 1]
