MyoRobotics/MyoRobotics-Documentation/source/controllers/images/jointSensorPCBLayout.pdf

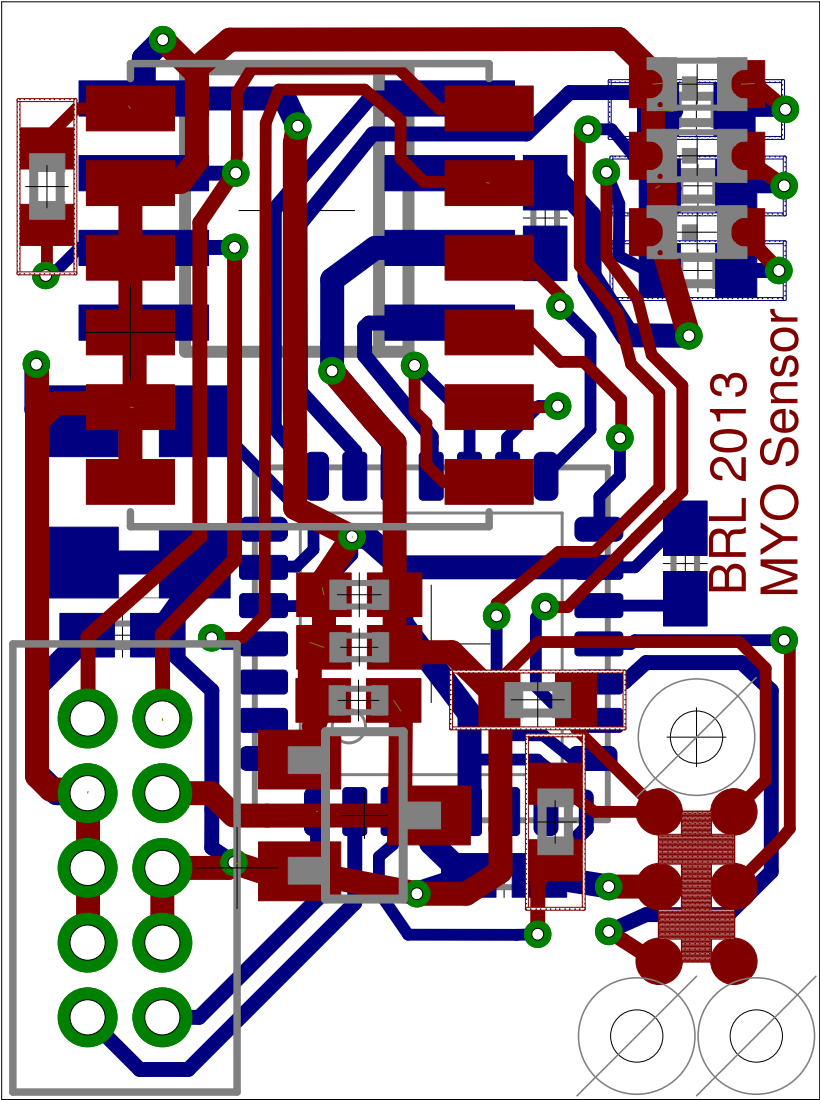
[picture p238: page 1]
