MyoRobotics/MyoRobotics-Documentation/source/controllers/images/LFC.pdf

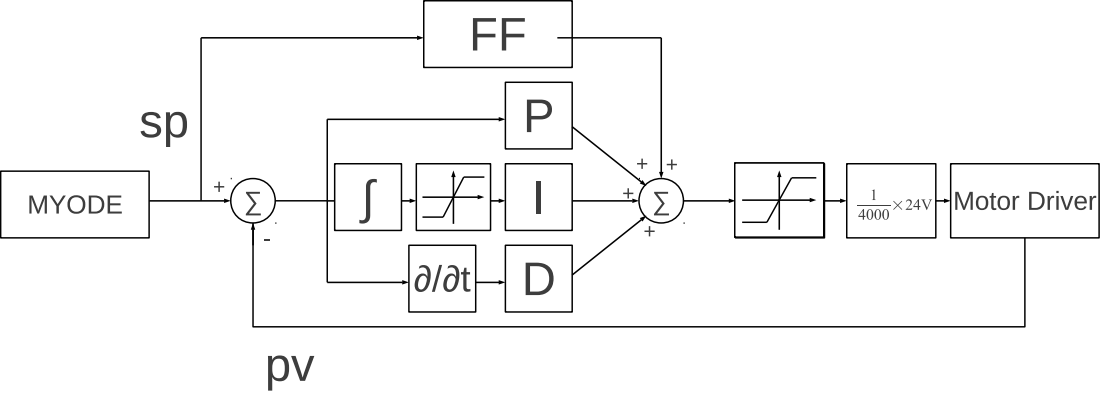
[picture p239: page 1]
