MyoRobotics/MyoRobotics-Documentation/source/controllers/images/MYOGanglionProcessorNoUsb.pdf

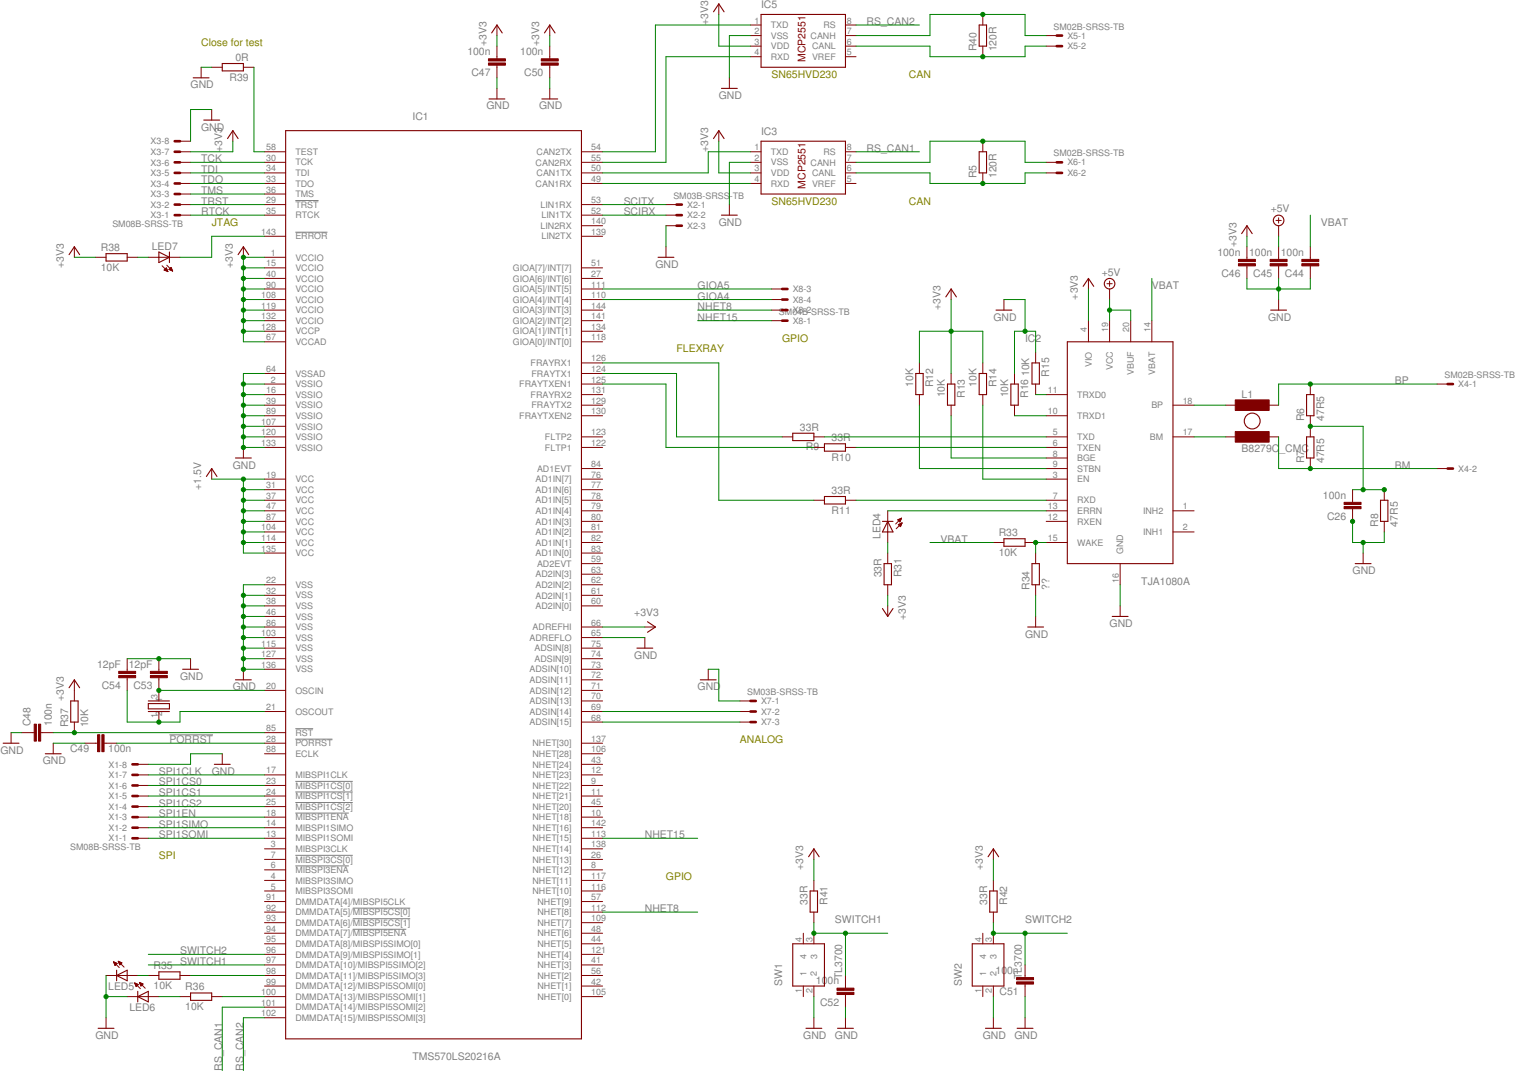
[picture p240: page 1]
