MyoRobotics/MyoRobotics-Documentation/source/controllers/images/CircuitDiagrams/jointSensorCircuitVersion4-crop.pdf

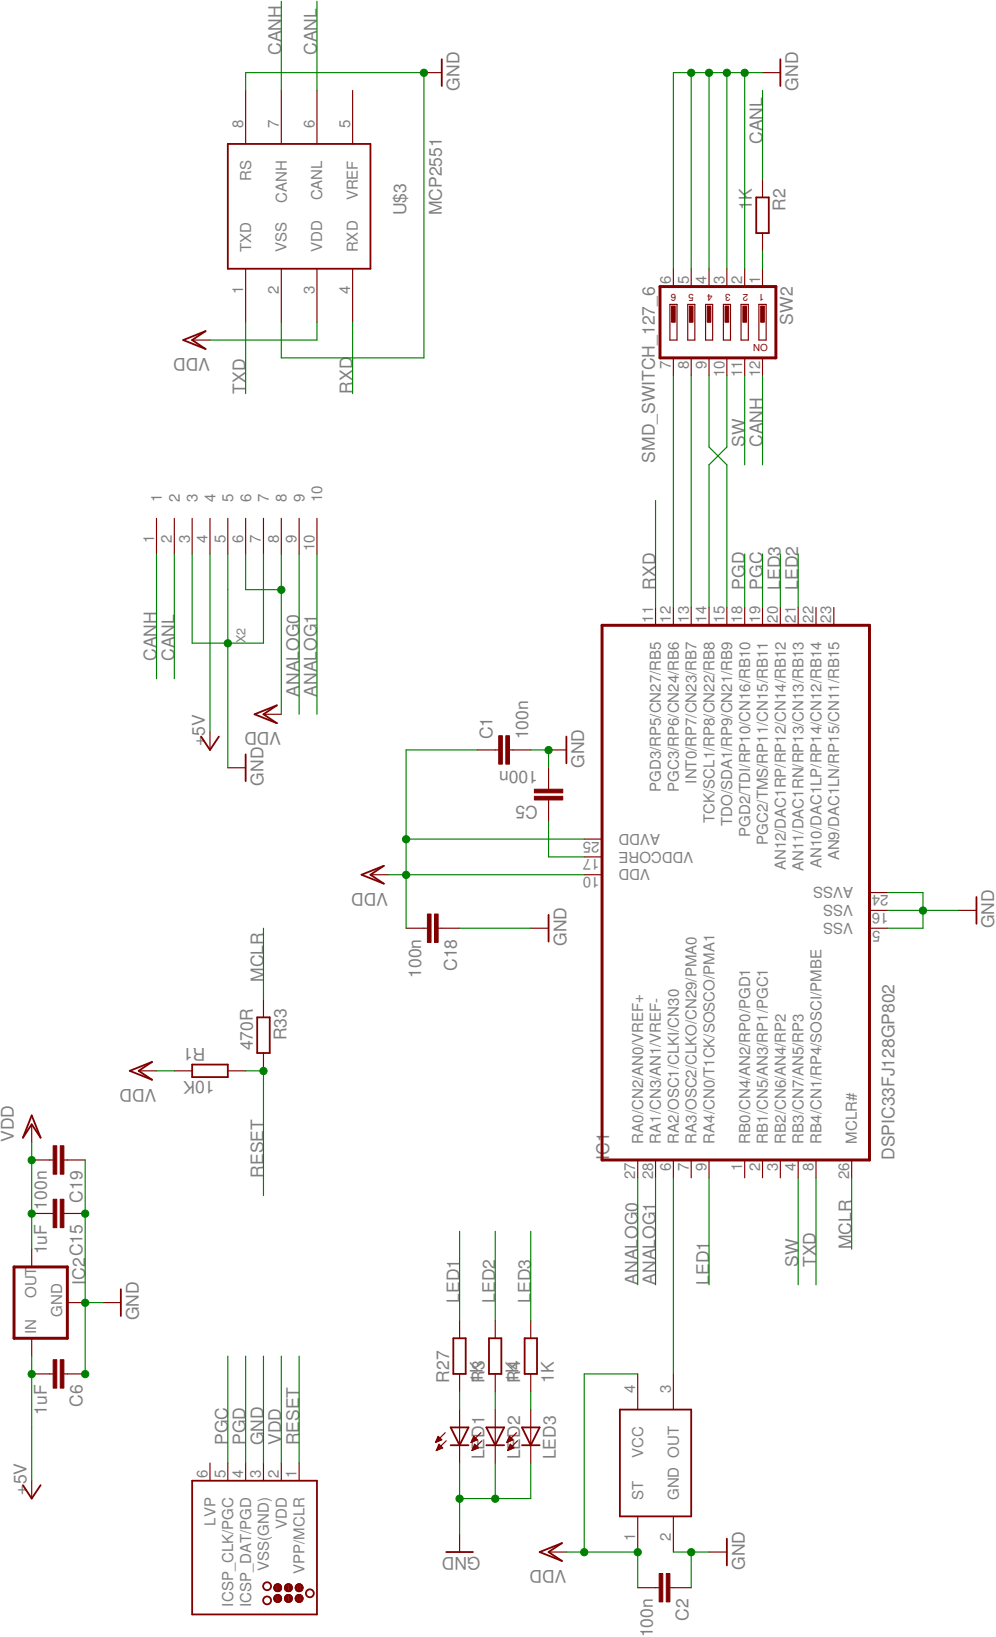
[picture p241: page 1]
