MyoRobotics/MyoRobotics-Documentation/source/controllers/images/CircuitDiagrams/MYOGanglionPowerSupply-crop.pdf

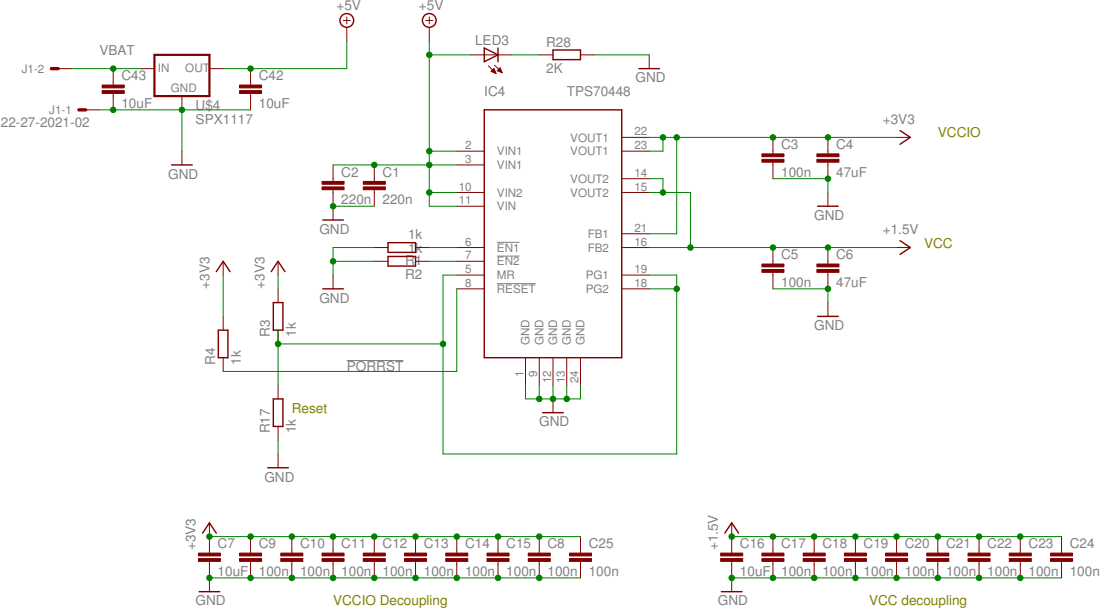
[picture p242: page 1]
