MyoRobotics/MyoRobotics-Documentation/source/controllers/images/CircuitDiagrams/MYOGanglionPowerSupply.pdf

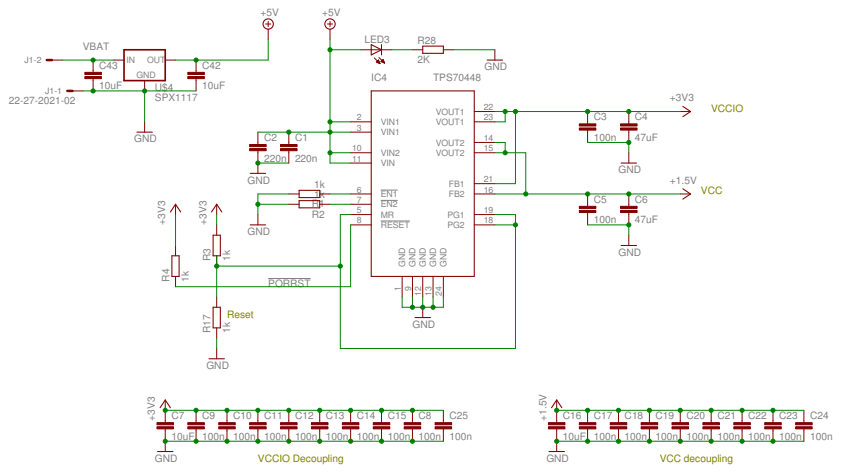
[picture p243: page 1]
