MyoRobotics/MyoRobotics-Documentation/source/controllers/images/CircuitDiagrams/MYOGanglioProcessorNoUsb.pdf

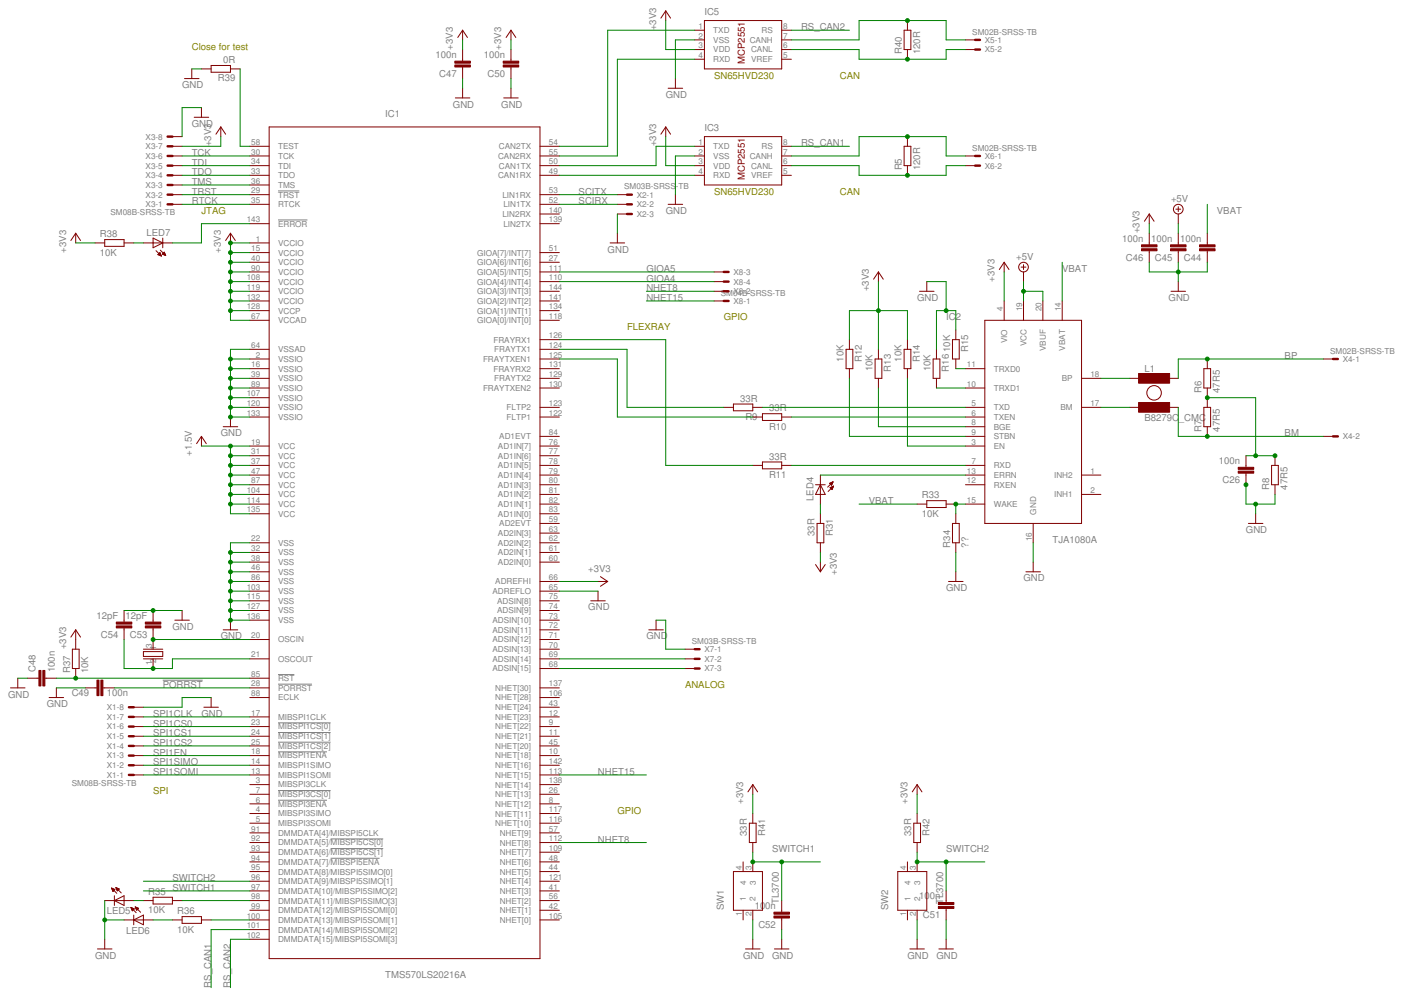
[picture p244: page 1]
