MyoRobotics/MyoRobotics-Documentation/source/controllers/images/CircuitDiagrams/MYO Ganglion no usb.brd

## EAGLE design source/controllers/images/CircuitDiagrams/MYO Ganglion no usb.brd (2017-05-03)

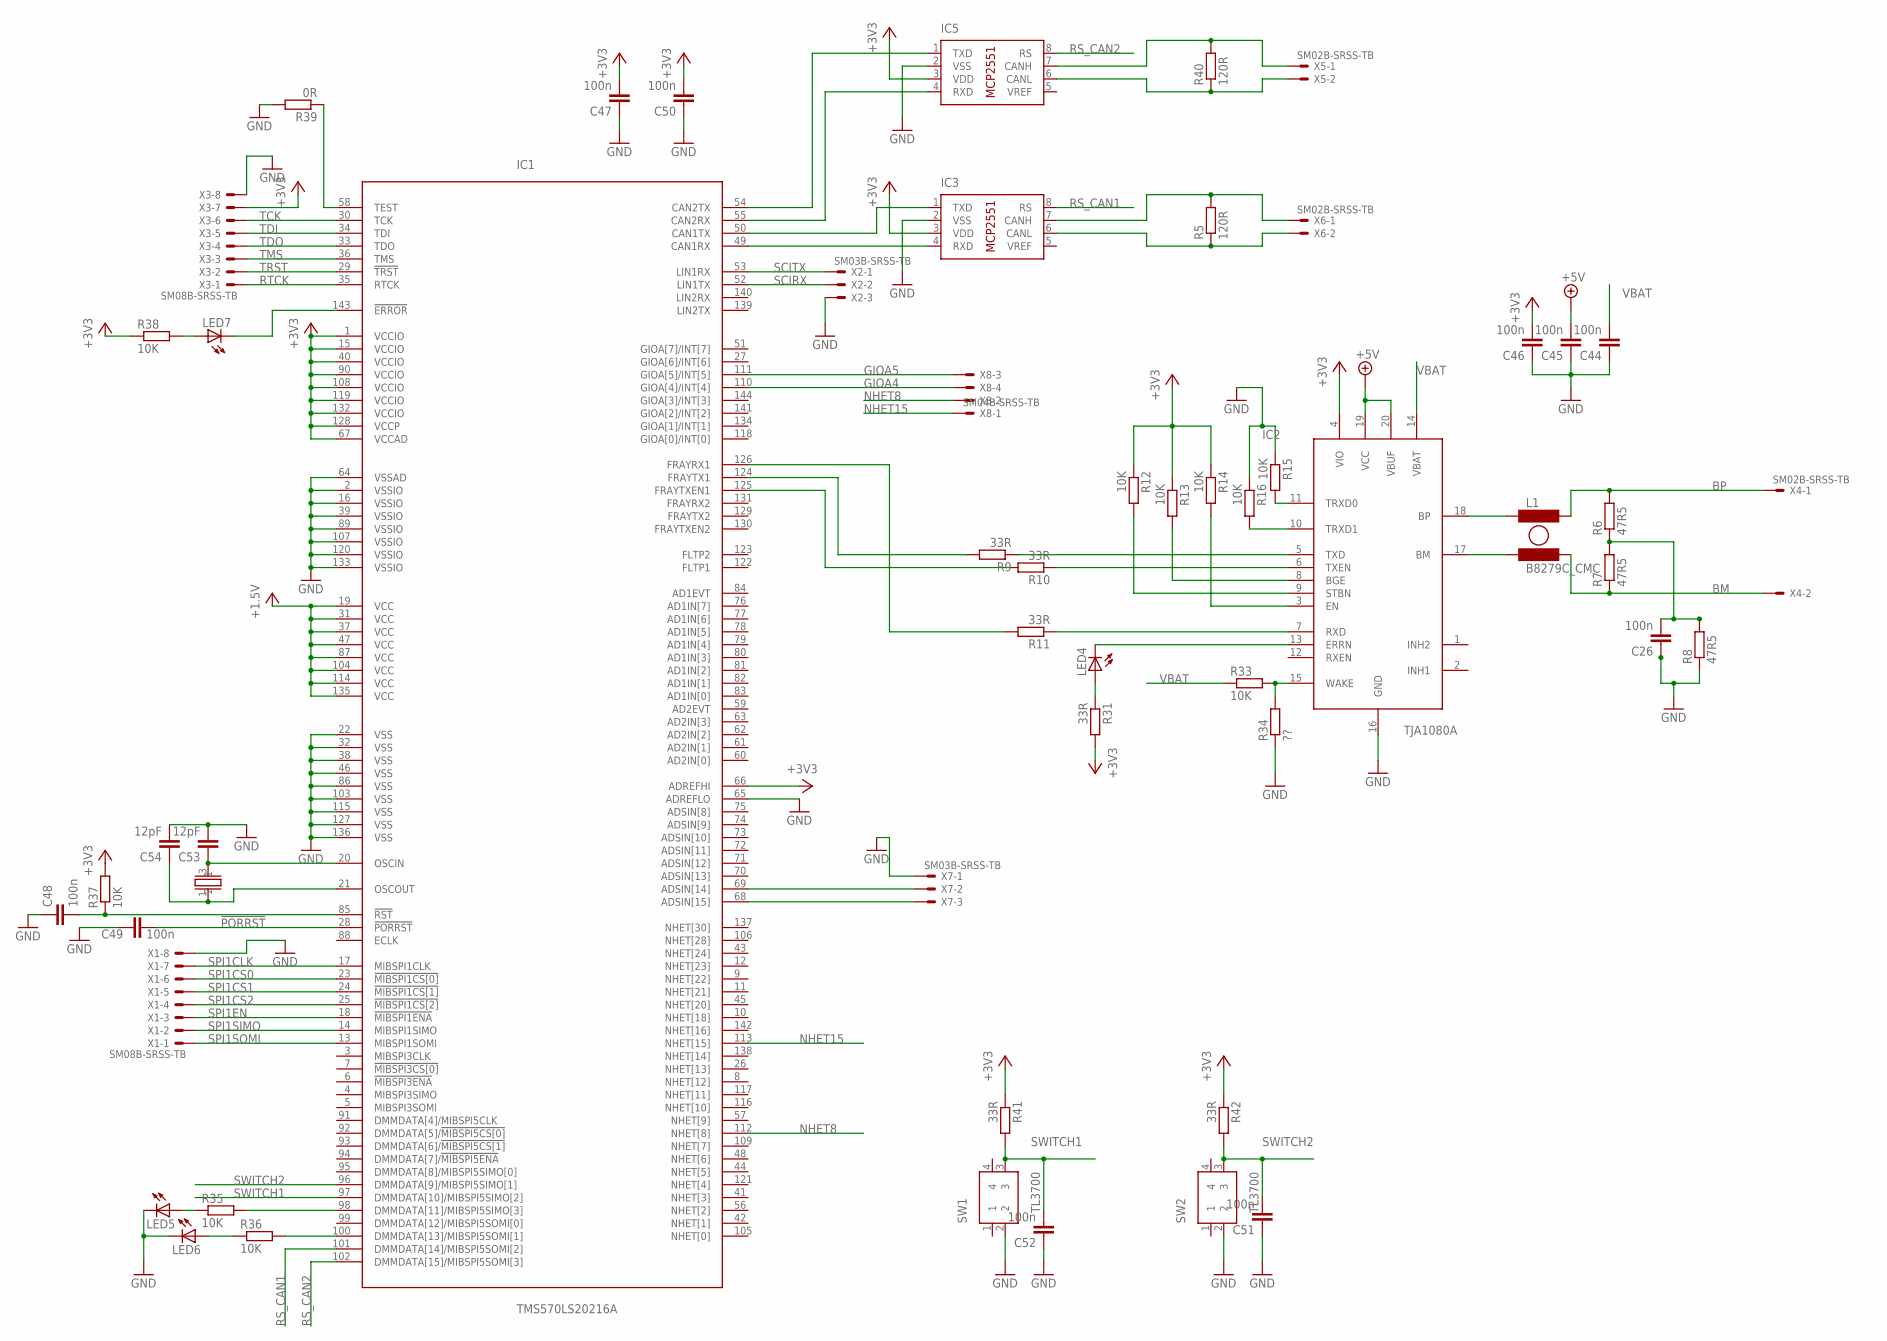
[picture p245: schematic MYO Ganglion no usb.sch, sheet 1]

Parts:
C26, C44, C45, C46, C47, C48, C49, C50, C51, C52: 100n; C0402K
C53, C54: 12pF; C0402K
IC1: TMS570LS20216A; PQFP144
IC2: TJA1080A; TSSOP20
IC3, IC5: MCP2551/SN; SO08
L1: B8279C_CMC; 1812CMC
LED4, LED5, LED6, LED7: LEDCHIPLED_0805; CHIPLED_0805
R5, R40: 120R; R0603
R6, R7, R8: 47R5; R0402
R9, R10, R11, R31, R41, R42: 33R; R0402
R12, R13, R14, R15, R16, R33, R35, R36, R37, R38: 10K; R0402
R34: ??; R0402
R39: 0R; R0402
SW1, SW2: TL3700
X1, X3: SM08B-SRSS-TB
X2, X7: SM03B-SRSS-TB
X4, X5, X6: SM02B-SRSS-TB
X8: SM04B-SRSS-TB
XT1: 2.5X2_XTAL

Connections:
!PORRST: C49.2, IC1.28 (!PORRST); also elsewhere on the board
+1V5: IC1.19 (VCC), IC1.31 (VCC), IC1.37 (VCC), IC1.47 (VCC), IC1.87 (VCC), IC1.104 (VCC), IC1.114 (VCC), IC1.135 (VCC); also elsewhere on the board
+3V3: C46.2, C47.2, C50.2, IC1.1 (VCCIO), IC1.15 (VCCIO), IC1.40 (VCCIO), IC1.66 (ADREFHI), IC1.67 (VCCAD), IC1.90 (VCCIO), IC1.108 (VCCIO), IC1.119 (VCCIO), IC1.128 (VCCP), IC1.132 (VCCIO), IC2.4 (VIO), IC3.3 (VDD), IC5.3 (VDD), R12.1, R13.1, R14.1, R31.2, R37.2, R38.1, R41.1, R42.1, X3.7; also elsewhere on the board
+5V: C45.2, IC2.19 (VCC), IC2.20 (VBUF); also elsewhere on the board
BM: L1.4, R7.1, X4.2
BP: L1.2, R6.2, X4.1
GIOA4: IC1.110 (GIOA[4]/INT[4]), X8.4
GIOA5: IC1.111 (GIOA[5]/INT[5]), X8.3
GND: C26.1, C44.1, C45.1, C46.1, C47.1, C48.1, C49.1, C50.1, C51.1, C52.1, C53.2, C54.2, IC1.2 (VSSIO), IC1.16 (VSSIO), IC1.22 (VSS), IC1.32 (VSS), IC1.38 (VSS), IC1.39 (VSSIO), IC1.46 (VSS), IC1.64 (VSSAD), IC1.65 (ADREFLO), IC1.86 (VSS), IC1.89 (VSSIO), IC1.103 (VSS), IC1.107 (VSSIO), IC1.115 (VSS), IC1.120 (VSSIO), IC1.127 (VSS), IC1.133 (VSSIO), IC1.136 (VSS), IC2.16 (GND), IC3.2 (VSS), IC5.2 (VSS), LED5.C, LED6.C, R8.1, R15.1, R16.1, R34.1, R39.2, SW1.2, SW2.2, X1.8, X2.3, X3.8, X7.1; also elsewhere on the board
unnamed: IC2.18 (BP), L1.1
unnamed: IC1.50 (CAN1TX), IC3.1 (TXD)
unnamed: IC1.49 (CAN1RX), IC3.4 (RXD)
unnamed: IC2.17 (BM), L1.3
unnamed: C53.1, IC1.20 (OSCIN), XT1.3 (2)
unnamed: C54.1, IC1.21 (OSCOUT), XT1.1
unnamed: IC3.7 (CANH), R5.2, X6.1
unnamed: IC3.6 (CANL), R5.1, X6.2
unnamed: IC2.5 (TXD), R9.1
unnamed: IC2.6 (TXEN), R10.1
unnamed: IC1.98 (DMMDATA[11]/MIBSPI5SIMO[3]), R35.2
unnamed: IC1.100 (DMMDATA[13]/MIBSPI5SOMI[1]), R36.2
unnamed: IC2.7 (RXD), R11.1
unnamed: C26.2, R6.1, R7.2, R8.2
unnamed: IC2.9 (STBN), R12.2
unnamed: IC2.8 (BGE), R13.2
unnamed: IC2.3 (EN), R14.2
unnamed: IC1.68 (ADSIN[15]), X7.3
unnamed: IC1.69 (ADSIN[14]), X7.2
unnamed: IC2.11 (TRXD0), R15.2
unnamed: IC2.10 (TRXD1), R16.2
unnamed: IC1.126 (FRAYRX1), R11.2
unnamed: IC1.124 (FRAYTX1), R9.2
unnamed: IC1.125 (FRAYTXEN1), R10.2
unnamed: LED4.A, R31.1
unnamed: IC2.13 (ERRN), LED4.C
unnamed: IC2.15 (WAKE), R33.2, R34.2
unnamed: LED5.A, R35.1
unnamed: LED6.A, R36.1
unnamed: IC1.54 (CAN2TX), IC5.1 (TXD)
unnamed: C48.2, IC1.85 (!RST), R37.1
unnamed: IC1.58 (TEST), R39.1
unnamed: IC1.143 (!ERROR), LED7.C
unnamed: LED7.A, R38.2
unnamed: IC1.55 (CAN2RX), IC5.4 (RXD)
unnamed: IC5.7 (CANH), R40.2, X5.1
unnamed: IC5.6 (CANL), R40.1, X5.2
NHET8: IC1.112 (NHET[8]), X8.2
NHET15: IC1.113 (NHET[15]), X8.1
RS_CAN1: IC1.101 (DMMDATA[14]/MIBSPI5SOMI[2]), IC3.8 (RS)
RS_CAN2: IC1.102 (DMMDATA[15]/MIBSPI5SOMI[3]), IC5.8 (RS)
RTCK: IC1.35 (RTCK), X3.1
SCIRX: IC1.52 (LIN1TX), X2.2
SCITX: IC1.53 (LIN1RX), X2.1
SPI1CLK: IC1.17 (MIBSPI1CLK), X1.7
SPI1CS0: IC1.23 (!MIBSPI1CS[0]), X1.6
SPI1CS1: IC1.24 (!MIBSPI1CS[1]), X1.5
SPI1CS2: IC1.25 (!MIBSPI1CS[2]), X1.4
SPI1EN: IC1.18 (!MIBSPI1ENA), X1.3
SPI1SIMO: IC1.14 (MIBSPI1SIMO), X1.2
SPI1SOMI: IC1.13 (MIBSPI1SOMI), X1.1
SWITCH1: C52.2, IC1.97 (DMMDATA[10]/MIBSPI5SIMO[2]), R41.2, SW1.3
SWITCH2: C51.2, IC1.96 (DMMDATA[9]/MIBSPI5SIMO[1]), R42.2, SW2.3
TCK: IC1.30 (TCK), X3.6
TDI: IC1.34 (TDI), X3.5
TDO: IC1.33 (TDO), X3.4
TMS: IC1.36 (TMS), X3.3
TRST: IC1.29 (!TRST), X3.2
VBAT: C44.2, IC2.14 (VBAT), R33.1; also elsewhere on the board

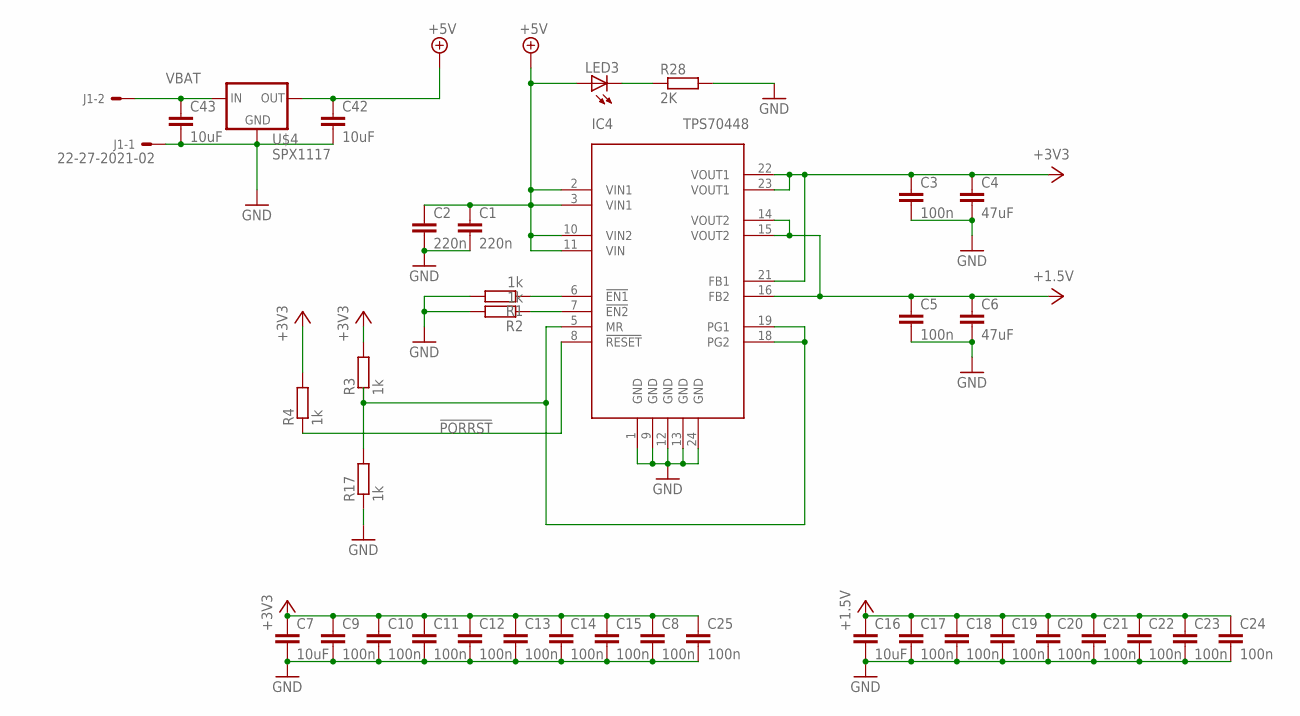
[picture p246: schematic MYO Ganglion no usb.sch, sheet 2]

Parts:
C1, C2: 220n; C0402K
C3, C5, C8, C9, C10, C11, C12, C13, C14, C15, C17, C18, C19, C20, C21, C22, C23, C24, C25: 100n; C0402K
C4, C6: 47uF; C0805K
C7, C16, C42, C43: 10uF; C0805K
IC4: TPS70448; HTSSOP24PWP
J1: 22-27-2021-02; 6410-02
LED3: LEDCHIPLED_0805; CHIPLED_0805
R1, R2, R3, R4, R17: 1k; R0402
R28: 2K; R0402
U$4: SPX1117; SOT223

Connections:
!PORRST: IC4.8 (!RESET), R4.1; also elsewhere on the board
+1V5: C5.1, C6.1, C16.1, C17.1, C18.1, C19.1, C20.1, C21.1, C22.1, C23.1, C24.1, IC4.14 (VOUT2), IC4.15 (VOUT2), IC4.16 (FB2); also elsewhere on the board
+3V3: C3.1, C4.1, C7.1, C8.1, C9.1, C10.1, C11.1, C12.1, C13.1, C14.1, C15.1, C25.1, IC4.21 (FB1), IC4.22 (VOUT1), IC4.23 (VOUT1), R3.2, R4.2; also elsewhere on the board
+5V: C1.1, C2.1, C42.1, IC4.2 (VIN1), IC4.3 (VIN1), IC4.10 (VIN2), IC4.11 (VIN), LED3.A, U$4.2 (OUT); also elsewhere on the board
GND: C1.2, C2.2, C3.2, C4.2, C5.2, C6.2, C7.2, C8.2, C9.2, C10.2, C11.2, C12.2, C13.2, C14.2, C15.2, C16.2, C17.2, C18.2, C19.2, C20.2, C21.2, C22.2, C23.2, C24.2, C25.2, C42.2, C43.2, IC4.1 (GND), IC4.9 (GND), IC4.12 (GND), IC4.13 (GND), IC4.24 (GND), J1.1, R1.2, R2.2, R17.1, R28.2, U$4.1 (GND); also elsewhere on the board
unnamed: IC4.6 (!EN1), R1.1
unnamed: IC4.7 (!EN2), R2.1
unnamed: IC4.5 (MR), IC4.18 (PG2), IC4.19 (PG1), R3.1, R17.2
unnamed: LED3.C, R28.1
VBAT: C43.1, J1.2, U$4.3 (IN); also elsewhere on the board

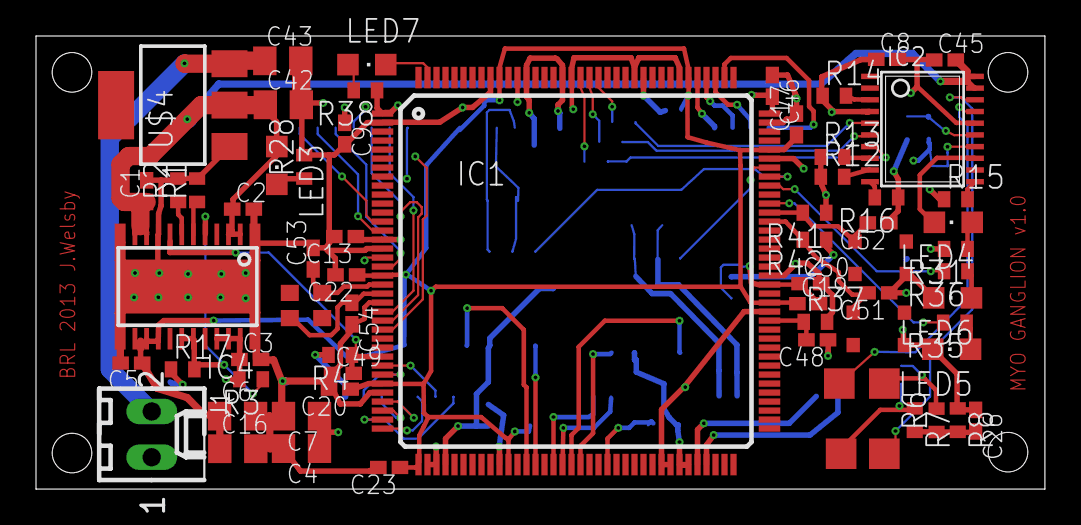
[picture p247: board MYO Ganglion no usb.brd from above]

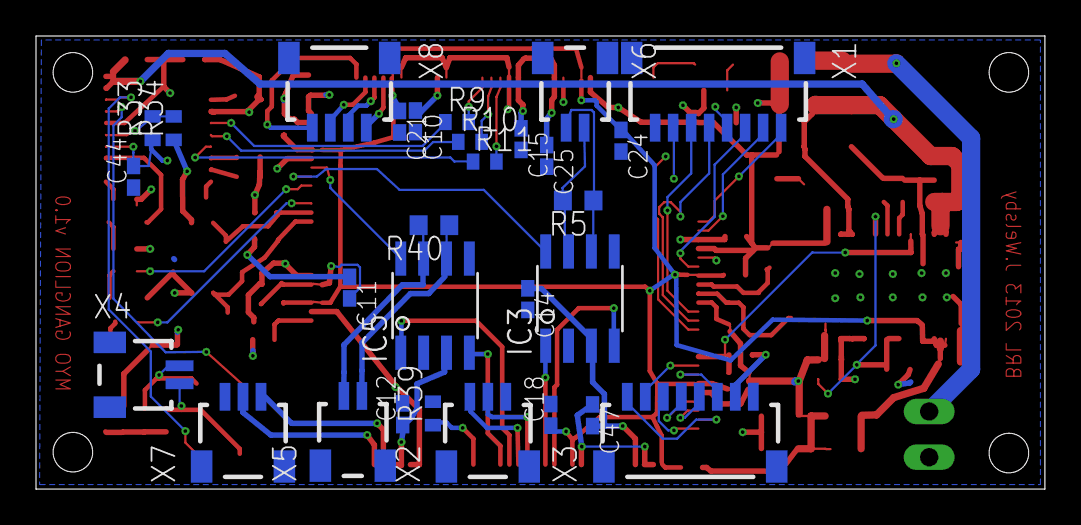
[picture p248: board MYO Ganglion no usb.brd from below]

Board: 4 copper layers, 56.0 x 25.2 mm, 92 parts (29 on the bottom side), 72 nets.
