MyoRobotics/MyoRobotics-Documentation/source/controllers/images/CircuitDiagrams/sensor pcb 3.brd

## EAGLE design source/controllers/images/CircuitDiagrams/sensor pcb 3.brd (2017-05-03)

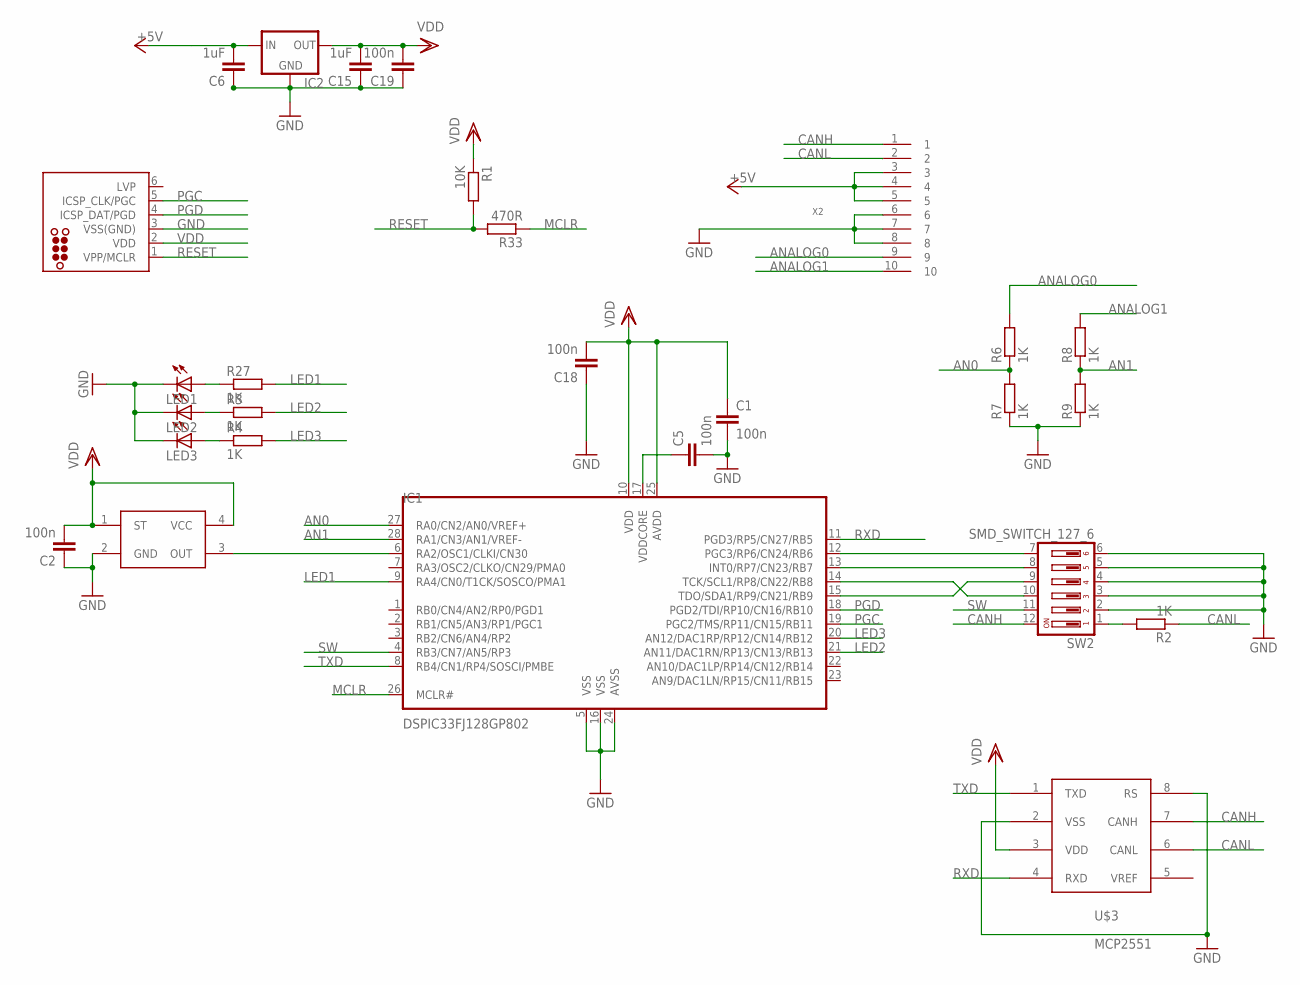
[picture p249: schematic sensor pcb 3.sch]

Parts:
C1, C2, C5, C18, C19: 100n; C0402K
C6, C15: 1uF; C0402K
IC1: DSPIC33FJ128GP802; QFN-S28-6X6
IC2: XC63FPM; SOT23
J1: TC2030-MCP-NL
LED1, LED2, LED3: LEDCHIPLED_0603; CHIPLED_0603
R1: 10K; R0402
R2, R3, R4, R6, R7, R8, R9, R27: 1K; R0402
R33: 470R; R0402
SW2: SMD_SWITCH_127_6
U$1: SG-310
U$3: MCP2551; 999
X2: 10PINJAS; 10PIN0.1

Connections:
+5V: C6.2, IC2.3 (IN), X2.3, X2.4, X2.5
AN0: IC1.27 (RA0/CN2/AN0/VREF+), R6.1, R7.2
AN1: IC1.28 (RA1/CN3/AN1/VREF-), R8.1, R9.2
ANALOG0: R6.2, X2.9
ANALOG1: R8.2, X2.10
CANH: SW2.12, U$3.7 (CANH), X2.1
CANL: R2.1, U$3.6 (CANL), X2.2
GND: C1.2, C2.1, C5.2, C6.1, C15.1, C18.1, C19.1, IC1.5 (VSS), IC1.16 (VSS), IC1.24 (AVSS), IC2.1 (GND), J1.3 (VSS(GND)), LED1.C, LED2.C, LED3.C, R7.1, R9.1, SW2.2, SW2.3, SW2.4, SW2.5, SW2.6, U$1.2 (GND), U$3.2 (VSS), U$3.8 (RS), X2.6, X2.7, X2.8
LED1: IC1.9 (RA4/CN0/T1CK/SOSCO/PMA1), R27.2
LED2: IC1.21 (AN11/DAC1RN/RP13/CN13/RB13), R3.2
LED3: IC1.20 (AN12/DAC1RP/RP12/CN14/RB12), R4.2
MCLR: IC1.26 (MCLR#), R33.1
unnamed: IC1.12 (PGC3/RP6/CN24/RB6), SW2.7
unnamed: IC1.13 (INT0/RP7/CN23/RB7), SW2.8
unnamed: IC1.15 (TDO/SDA1/RP9/CN21/RB9), SW2.9
unnamed: IC1.14 (TCK/SCL1/RP8/CN22/RB8), SW2.10
unnamed: IC1.6 (RA2/OSC1/CLKI/CN30), U$1.3 (OUT)
unnamed: C5.1, IC1.17 (VDDCORE)
unnamed: R2.2, SW2.1
unnamed: LED2.A, R3.1
unnamed: LED3.A, R4.1
unnamed: LED1.A, R27.1
PGC: IC1.19 (PGC2/TMS/RP11/CN15/RB11), J1.5 (ICSP_CLK/PGC)
PGD: IC1.18 (PGD2/TDI/RP10/CN16/RB10), J1.4 (ICSP_DAT/PGD)
RESET: J1.1 (VPP/MCLR), R1.2, R33.2
RXD: IC1.11 (PGD3/RP5/CN27/RB5), U$3.4 (RXD)
SW: IC1.4 (RB3/CN7/AN5/RP3), SW2.11
TXD: IC1.8 (RB4/CN1/RP4/SOSCI/PMBE), U$3.1 (TXD)
VDD: C1.1, C2.2, C15.2, C18.2, C19.2, IC1.10 (VDD), IC1.25 (AVDD), IC2.2 (OUT), J1.2 (VDD), R1.1, U$1.1 (ST), U$1.4 (VCC), U$3.3 (VDD)

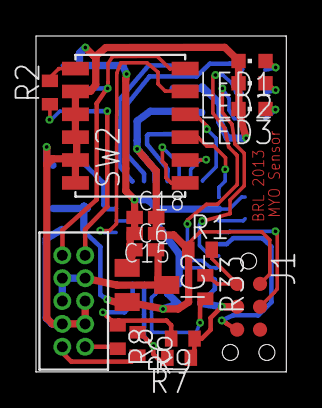
[picture p250: board sensor pcb 3.brd from above]

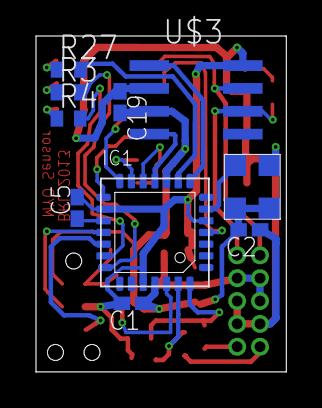
[picture p251: board sensor pcb 3.brd from below]

Board: 2 copper layers, 13.9 x 18.7 mm, 27 parts (10 on the bottom side), 29 nets.
