MyoRobotics/MyoRobotics-Documentation/source/controllers/images/CircuitDiagrams/MYO connector 2.brd

## EAGLE design source/controllers/images/CircuitDiagrams/MYO connector 2.brd (2017-05-03)

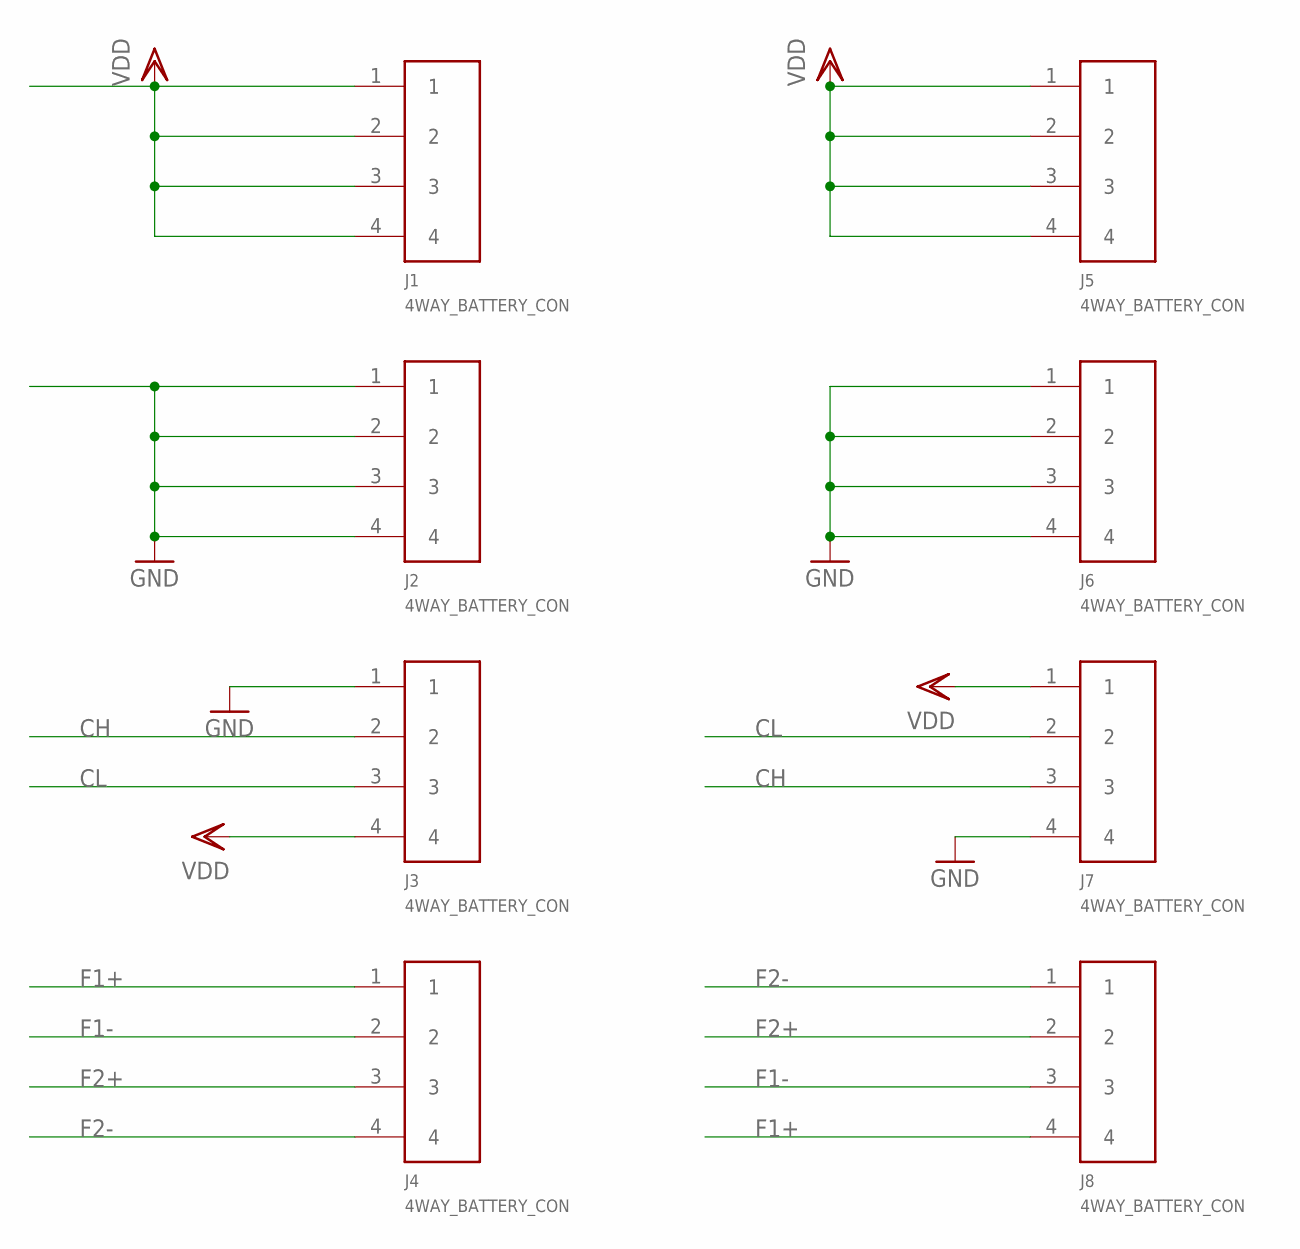
[picture p252: schematic MYO connector 2.sch]

Parts:
J1, J2, J3, J4, J5, J6, J7, J8: 4WAY_BATTERY_CON; 4-WAY-BATTERY_CON

Connections:
CH: J3.2, J7.3
CL: J3.3, J7.2
F1+: J4.1, J8.4
F1-: J4.2, J8.3
F2+: J4.3, J8.2
F2-: J4.4, J8.1
GND: J2.1, J2.2, J2.3, J2.4, J3.1, J6.1, J6.2, J6.3, J6.4, J7.4
VDD: J1.1, J1.2, J1.3, J1.4, J3.4, J5.1, J5.2, J5.3, J5.4, J7.1

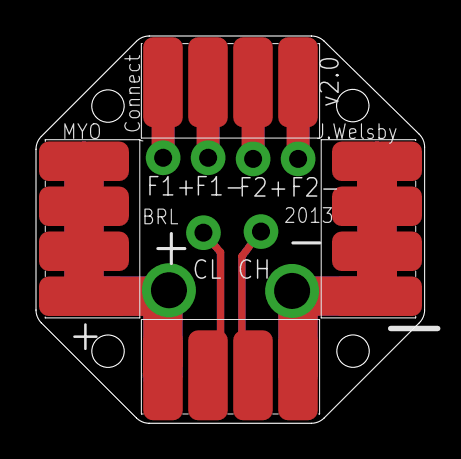
[picture p253: board MYO connector 2.brd from above]

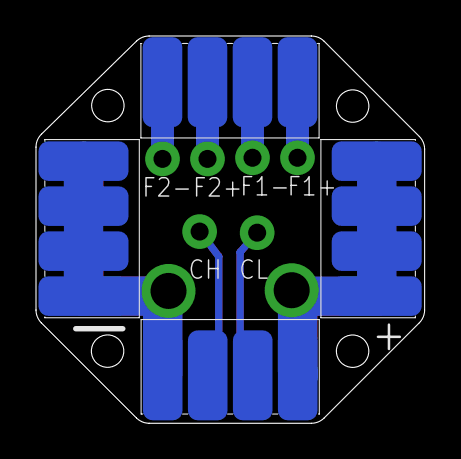
[picture p254: board MYO connector 2.brd from below]

Board: 2 copper layers, 21.6 x 21.5 mm, 8 parts (4 on the bottom side), 8 nets.
