MyoRobotics/MyoRobotics-Documentation/source/controllers/images/CircuitDiagrams/MYO power distribution pcb.brd

## EAGLE design source/controllers/images/CircuitDiagrams/MYO power distribution pcb.brd (2017-05-03)

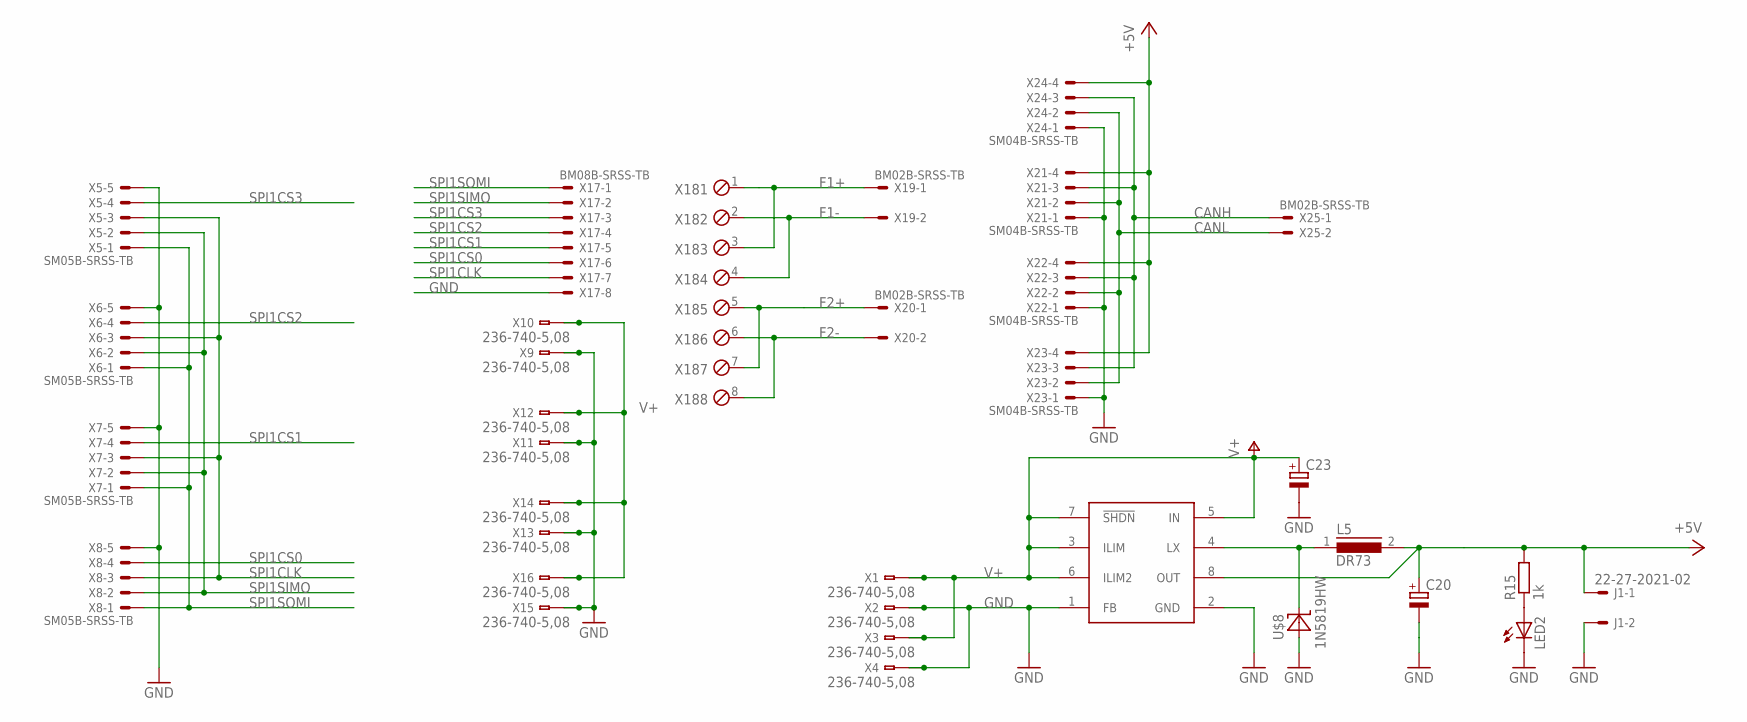
[picture p255: schematic MYO power distribution pcb.sch]

Parts:
C20, C23: CPOL-EUC/6032-28R; C/6032-28R
J1: 22-27-2021-02; 6410-02
L5: DR73
LED2: LEDCHIP-LED0805; CHIP-LED0805
R15: 1k; R0603
U$5: MAX1776; UMAX8
U$8: 1N5819HW; SOD123
X1, X2, X3, X4, X9, X10, X11, X12, X13, X14, X15, X16: 236-740-5,08; 236-4XX
X5, X6, X7, X8: SM05B-SRSS-TB
X17: BM08B-SRSS-TB
X18: CON_PTSA_8; PHOENIX_PSTA_8
X19, X20, X25: BM02B-SRSS-TB
X21, X22, X23, X24: SM04B-SRSS-TB

Connections:
+5V: C20.+, J1.1, L5.2, R15.2, U$5.8 (OUT), X21.4, X22.4, X23.4, X24.4
CANH: X21.3, X22.3, X23.3, X24.3, X25.1
CANL: X21.2, X22.2, X23.2, X24.2, X25.2
F1+: X18.1, X18.3, X19.1
F1-: X18.2, X18.4, X19.2
F2+: X18.5, X18.7, X20.1
F2-: X18.6, X18.8, X20.2
GND: C20.-, C23.-, J1.2, LED2.C, U$5.1 (FB), U$5.2 (GND), U$8.A, X2.1@1 (A1), X2.1@2 (B1), X4.1@1 (A1), X4.1@2 (B1), X5.5, X6.5, X7.5, X8.5, X9.1@1 (A1), X9.1@2 (B1), X11.1@1 (A1), X11.1@2 (B1), X13.1@1 (A1), X13.1@2 (B1), X15.1@1 (A1), X15.1@2 (B1), X17.8, X21.1, X22.1, X23.1, X24.1
unnamed: LED2.A, R15.1
unnamed: L5.1, U$5.4 (LX), U$8.C
SPI1CLK: X5.3, X6.3, X7.3, X8.3, X17.7
SPI1CS0: X8.4, X17.6
SPI1CS1: X7.4, X17.5
SPI1CS2: X6.4, X17.4
SPI1CS3: X5.4, X17.3
SPI1SIMO: X5.2, X6.2, X7.2, X8.2, X17.2
SPI1SOMI: X5.1, X6.1, X7.1, X8.1, X17.1
V+: C23.+, U$5.3 (ILIM), U$5.5 (IN), U$5.6 (ILIM2), U$5.7 (!SHDN), X1.1@1 (A1), X1.1@2 (B1), X3.1@1 (A1), X3.1@2 (B1), X10.1@1 (A1), X10.1@2 (B1), X12.1@1 (A1), X12.1@2 (B1), X14.1@1 (A1), X14.1@2 (B1), X16.1@1 (A1), X16.1@2 (B1)

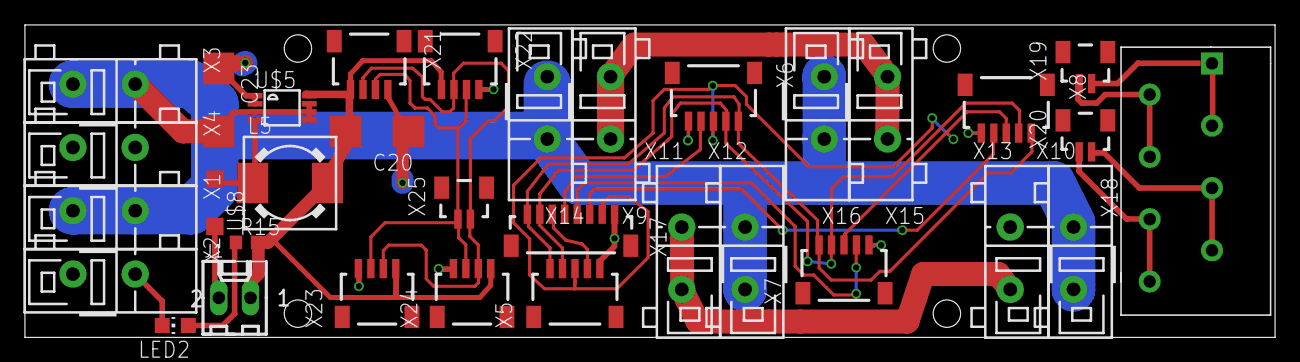
[picture p256: board MYO power distribution pcb.brd from above]

Board: 2 copper layers, 100.3 x 25.1 mm, 33 parts (0 on the bottom side), 18 nets.
