MyoRobotics/MyoRobotics-Documentation/source/controllers/images/CircuitDiagrams/displacement sensor.brd

## EAGLE design source/controllers/images/CircuitDiagrams/displacement sensor.brd (2017-05-03)

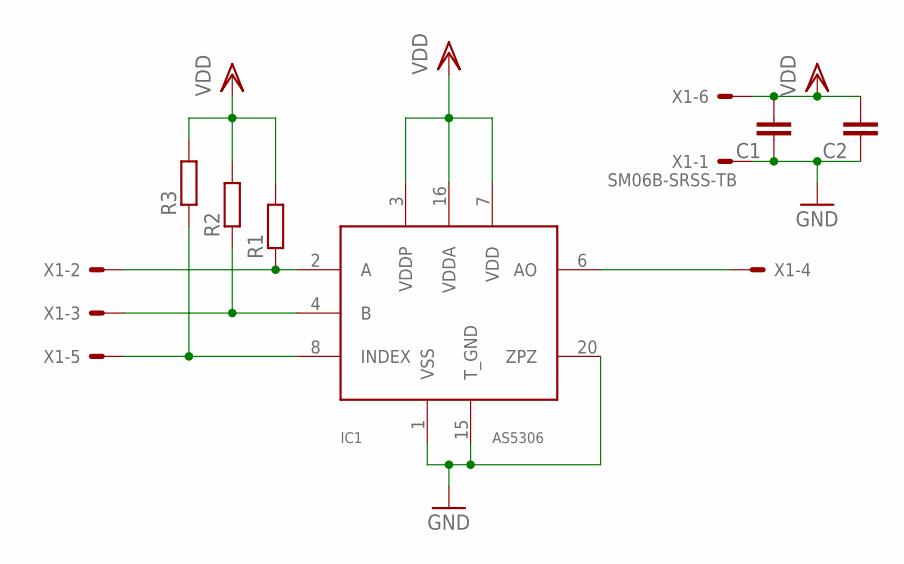
[picture p257: schematic displacement sensor.sch]

Parts:
C1, C2: C-EUC0402K; C0402K
IC1: AS5306; TSSOP20
R1, R2, R3: R-EU_R0402; R0402
X1: SM06B-SRSS-TB

Connections:
GND: C1.1, C2.1, IC1.1 (VSS), IC1.15 (T_GND), IC1.20 (ZPZ), X1.1
unnamed: IC1.6 (AO), X1.4
unnamed: IC1.2 (A), R1.1, X1.2
unnamed: IC1.4 (B), R2.1, X1.3
unnamed: IC1.8 (INDEX), R3.1, X1.5
VDD: C1.2, C2.2, IC1.3 (VDDP), IC1.7 (VDD), IC1.16 (VDDA), R1.2, R2.2, R3.2, X1.6

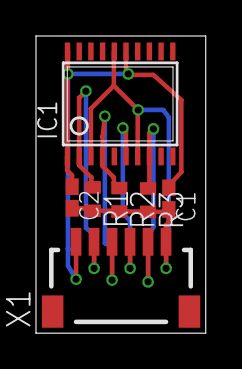
[picture p258: board displacement sensor.brd from above]

Board: 2 copper layers, 9.4 x 16.5 mm, 7 parts (0 on the bottom side), 6 nets.
