MyoRobotics/MyoRobotics-Documentation/(commit log)

2017-03-23 small changes
    [MYO Ganglion no usb.brd, MYO Ganglion no usb.sch, MYO connector 2.brd, MYO connector 2.sch, MYO power distribution pcb.brd, MYO power distribution pcb.sch, displacement sensor.brd, displacement sensor.sch]
2017-03-29 assembly first changes
2017-03-30 Updated Index with Assembly
2017-03-30 started working on Assembly
2017-04-04 Assembly changes
2017-04-06 Amendements to the asymetric joint
2017-04-06 Amendments to the wires and adding of muscle table
    [20170406-Muscle-11.csv]
2017-04-12 Added aligni tables
    [20170406-J22Asymmetricjoint-A_complete .csv, 20170406-Muscle-11.csv, 20170406-Muscle-12.csv]
2017-05-01 Add all new ganglion mounting options
2017-05-03 Reordering and breaking into small files
    [20170406-J22Asymmetricjoint-A_complete.csv, 20170406-Muscle-12.csv]
2017-05-03 Add captions to muscle assembly
2017-05-03 Reformat J22 assembly instructions
    [20170406-J22Asymmetricjoint-A_complete.csv]
2017-05-03 Restructure bone assembly
    [MyoBoneRexroth20mm.csv]
2017-05-03 Add applications section with MyoArm
    [MyoArmV1.2.csv]
